Kanishk234/dwn-fpga-study/docs/technical-report.md

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

**Kanishk Sama · Krithik Sama**
The University of Texas at Austin

---

## Abstract

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

We built a hand-written Verilog implementation and a generator that compiles a trained checkpoint
into synthesizable hardware, verified every configuration bit-exactly against a software reference,
and deployed one to the board, where it classified all 166,000 test samples with zero mismatches.
We then swept 54 configurations through place-and-route to map the accuracy/area/latency frontier,
and compared the result against a gradient-boosted decision tree compiled to the same part through
the same synthesis flow.

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

---

## 1. Introduction

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

Differentiable Weightless Neural Networks [1] made this practical by showing how to train such
tables with gradient descent. The published results are strong, but they are demonstrated on a
Xilinx Virtex UltraScale+ VU9P, a data-centre part with roughly 1.18 million lookup tables. The
obvious question — whether the approach still works when the device is small — was open, and it is
not a question that theory answers, because on a small device the cost of preparing the *input* can
exceed the cost of the network itself.

This report answers it. Our contributions:

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

3. **A controlled comparison against a gradient-boosted decision tree** on identical silicon
   through an identical synthesis flow, rather than across papers and parts.

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

### 1.1 What we did not do

We did not measure a quantised multilayer perceptron compiled by hls4ml on our part. Its published
design needs three times our device's capacity, so it cannot fit unshrunk; shrinking it until it
fits is a separate experiment we did not run. Section 6.4 states the consequence, which is that our
comparison rests on one measured baseline rather than two.

---

## 2. Background

### 2.1 Lookup tables, in hardware and in the model

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

### 2.2 The architecture

A DWN processes data in four stages.

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

**Decision.** The class with the highest count wins, resolved by an argmax circuit.

No stage multiplies. The entire network is memory reads, one adder tree, and one comparison tree.

### 2.3 The encoder is not free

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

---

## 3. Implementation

### 3.1 Structure

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

### 3.2 Verification

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

Two experiences justify the strictness.

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

### 3.3 On real hardware

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

---

## 4. Design-space exploration

### 4.1 Method

Fifty-four configurations were trained and put through synthesis and place-and-route on the target
part at a 10 ns clock, out of context (that is, without surrounding system logic, so measurements
reflect the design alone). Fifty-two produced measurements; two were unbuildable for a reason
given in Section 8. Forty-one both fit the device and met the 100 MHz board clock.

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

### 4.2 Results

**Figure 1.** Accuracy against area for every configuration measured on our device, alongside
published results on the same dataset. Marker fill distinguishes designs whose area includes the
input encoder from those reporting the network alone; the two are not interchangeable (Section 5.2).

Accuracy against area, OpenML dataset

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

Four findings follow.

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

---

## 5. Comparing against published work is harder than it looks

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

### 5.1 "Jet substructure classification" is two datasets

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

The authors of NeuraLUT-Assemble state the situation plainly [4]:

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

**Consequence.** The comparison most often quoted — DWN against LogicNets, PolyLUT and NeuraLUT —
is across datasets. Those are CERNBox results. On the OpenML data the honest peer group is smaller
and stronger: DWN, TreeLUT, NeuraLUT-Assemble, FPGN, and hls4ml.

### 5.2 Area figures mix two conventions

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

### 5.3 Both defects begin upstream

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

---

## 6. Comparison results

### 6.1 Against a boosted decision tree, on identical silicon

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

**At a fixed area budget, which model is more accurate:**

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

**At a fixed accuracy target, which model is smaller:**

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

### 6.2 A conversion bug that would have invalidated every tree result

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

### 6.3 Against published work, on our dataset

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

| Method | Accuracy | Lookup tables | Encoder included | Part |
|---|---|---|---|---|
| **This work** (largest fitting) | **76.35%** | 18,777 | yes | XC7A35T |
| DWN, as published | 76.3% | 4,972 | **no** | VU9P |
| DWN, encoder included [3] | 76.3% | 7,011 | yes | VU9P |
| **This work** (headline) | **76.18%** | **12,751** | yes | XC7A35T |
| hls4ml [9] | 76.0% | 63,251 | n/a | VU9P |
| TreeLUT [7] | 76.0% | 2,234 | n/a | VU9P |
| NeuraLUT-Assemble [4] | 76.0% | **1,780** | n/a | VU9P |
| FPGN [5] | 76.0% | 3,345 | unstated | VU9P |
| Boosted tree (this work) | 74.88% | 15,363 | n/a | XC7A35T |

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

### 6.4 What is missing

We did not synthesize an hls4ml design on our part. Its published configuration needs 63,251
lookup tables against our 20,800 — three times over, which is arithmetic rather than an experiment.
What we therefore cannot report is **how much accuracy hls4ml retains when shrunk until it fits**,
which is a genuine open question.

This has a specific consequence. The "no DSP blocks" property is the sharpest distinction against
hls4ml, whose quantised networks spend 38 of them. But the boosted tree also uses none — trees do
not multiply either. **So on our own silicon that distinction is untested**; it rests on published
figures alone. A measurement of one shrunk hls4ml configuration would close this, and is in
progress at the time of writing.

---

## 7. The input word was six bits too wide

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

**The cause is comparator width, and nothing else.** That work normalises features to [−1, 1) and
quantises them to 6–9 bits. We carried a 16-bit word whose three integer bits exist only because
our features are standardised to roughly ±4.5, and whose twelve fractional bits are far finer than
the spacing between adjacent thresholds. Rebuilt at 8 bits, our encoder measures **182** lookup
tables against their 201. No structural technique was missing; the numbers were simply wider than
they needed to be.

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

Two further observations:

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

---

## 8. Limitations and threats to validity

**One measured baseline, not two.** With hls4ml unmeasured (Section 6.4), the controlled comparison
rests on boosted trees alone.

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

---

## 9. Conclusion

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

---

## References

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

[6] *A Survey on LUT-based Deep Neural Networks Implemented in FPGAs.* 2025. arXiv:2506.07367.

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

---

## Appendix A — How configurations are named

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

---

## Appendix B — Complete measurements

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

### B.1 Weightless network, representative configurations

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

### B.2 Boosted decision trees, all fitting configurations

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

### B.3 Encoder area against input word width

Measured on `1x2400 z=50`, 746 wired comparators, encoder synthesized alone.

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

### B.4 Published results, OpenML dataset only

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

---

## Appendix C — Reproducing this work

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

---

## Glossary

**argmax** — the circuit that selects the highest-scoring class. Ties resolve to the lowest index.

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

**critical path** — the slowest chain of logic between two registers. It sets the maximum clock
frequency.

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

**FPGA** — a chip whose logic is configured after manufacture, built largely from lookup tables.

**Fmax** — the highest clock frequency at which a design meets timing.

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

**popcount** — counting the ones in a group of bits. How class scores are computed here.

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
