Kanishk234/dwn-fpga-study/docs/phase1-ledger.md

# Phase 1 — CORE: running ledger

# ✅ PHASE 1 COMPLETE — Gate 1b passed 2026-08-04, 166,000/166,000 on hardware

**Live document. Update it as work lands, not afterwards.** Status table first, then the
chronological log, then the numbers worth quoting, then what is still open.

Phase 1's exit condition is Gate 1b (brief §11): *the bitstream running on the Basys 3
reproduces the software model's JSC test-set accuracy, to the sample.* Not "it lights the right
LED for a few inputs" — the full test set through benchmark mode, matching what PyTorch
reported. **That is now done.**

---

## Status

| Step | What | Status |
|---|---|---|
| **1a** | LUT6 mapping probe — does `TABLE[addr]` map to one LUT6? | ✅ risk #1 retired, `docs/probe-results.md` |
| **1b** | Reproduce DWN training; JSC checkpoint we trust | ✅ 74.06% vs paper's 74.0% |
| **1c** | Verilog templates, by hand, for one small real model | ✅ core + encoder |
| **1d** | Golden software model + bit-exact testbench — **GATE 1** | ✅ **both levels pass** |
| **1e** | Exporter (checkpoint → tables/wiring/thresholds) | 🟡 works, one-shot, not generalized |
| **1f** | RTL generator (export → Verilog) | ❌ `rtlgen/` empty |
| **1g** | Harness — UART, BRAM vector store, cycle counter, FSM, 7-seg | ✅ **all modules built and tested, incl. board top level** |
| **1h** | Board: bitstream reproduces test-set accuracy — **GATE 1b** | ✅ **166,000/166,000** |

### Not in the brief's list, but Phase 1 cannot finish without them

| Item | Why it matters | Status |
|---|---|---|
| `constraints/basys3.xdc` | required for a *bitstream*; OOC synthesis does not need it | ✅ |
| Bitstream | the real design, pins and all | ✅ **builds, meets timing** |
| `scripts/build.tcl` | non-project-mode build; the DSE sweep reuses it | ✅ |
| First synthesis run | the encoder-vs-core LUT split (brief §6) — unmeasured | ✅ **see below** |
| Pipeline registers (II=1) | brief §9; also a Phase 2 sweep axis | ✅ 4 stages, 161 MHz, II=1 |
| Full 166k test set | Gate 1b needs the whole set | ✅ produced and verified — see below |
| Host driver (`scripts/host.py`) | drives the `L`/`R`/`S` protocol, batches Gate 1b | ✅ encoding self-tested |

---

## Log

### 2026-08-02

- **1a probe** — `TABLE[addr]` maps to a single LUT6 as hoped. Risk #1 retired
  (`docs/probe-results.md`). This was the branch point for the whole area model.
- **Submodule pinned** at `9f887a0`. Upstream ships **PyTorch training only** — no RTL, no HLS,
  no FPGA flow. Confirms the gap the project exists to fill.
- **Kaggle training brought up.** `torch_dwn` has no CPU path (`EFDFunction CPU not
  Implemented`), so training runs off-machine. First build failed: upstream's `pyproject.toml`
  declares `torch` as a *build* requirement, so plain `pip install .` builds in an isolated env
  against a second, mismatched torch. Fix: `--no-build-isolation`.
- **Three training runs, three rejected hypotheses** — see `training/README.md` run log.
  z=4→8 bought +0.22pp; batch 256→32 bought +0.07pp; reading upstream showed lr/scheduler/
  epochs/tau/mapping already matched the authors' recipe exactly.
- **Checkpoint format recorded** from the pinned submodule, not inferred —
  `docs/checkpoint-format.md`. Closes risk #5.
- **Read the paper.** Table 14 gave the real JSC configs (`docs/paper-configs.md`): **z=200**
  and **single-layer**. We had been at z≤8 with a random-wired second layer.
- **Reproduced the paper's `sm` (1×50)**: 74.06% best / 73.84% final vs the paper's 74.0%.
  This is the Gate 1 reference checkpoint.
- **Python 3.12** chosen and pinned (`requirements.txt` header has the reasoning — Kaggle
  parity, and Phase 3's hls4ml/conifer lag new releases).
- **Extractor** (`exporter/extract.py`) — pulls tables/wiring/thresholds and verifies itself
  with a numpy forward pass against PyTorch's own predictions: **1000/1000**.

### 2026-08-03

- **Core RTL.** Hand-written `rtl/lut_node.v`, `popcount.v`, `argmax.v`; model-specific
  `rtl/gen/dwn_core.v` emitted by `exporter/emit_core.py`, which parses its own output back and
  checks tables, wire indices, and address bit order against the checkpoint.
- **GATE 1 PASSED (core)** — 1504/1504 via xsim. Vivado is at
  `C:\AMDDesignTools\2025.2\Vivado\bin`, not `C:\Xilinx`.
- **Precision measured, not guessed** (`exporter/analyze_precision.py`). Chose **Q3.12,
  16-bit**; **Q3.15/19-bit is the zero-bit-error fallback** if it is ever needed.
- **Gate 1 runner converted** from PowerShell to Python so `dse/` can import `run_xsim()` in
  Phase 2 instead of shelling out.
- **Thermometer encoder.** `exporter/emit_encoder.py` emits 202 comparators + `dwn_top`, with
  its own read-back check (202/202).
- **GATE 1 PASSED (top)** — 1518/1518 end to end, quantized features → encoder → core.
- **First synthesis run** (`scripts/build.tcl`, `scripts/run_synth.py`), out-of-context on
  `xc7a35tcpg236-1`. Two significant results — see *Area* and *Timing* below.
- **Pipelined.** Four stages via a parameterized `pipe_reg`, latency 4 cycles, II=1.
  81.2 → **161.0 MHz**, LUT count unchanged. Gate 1 re-run and still passing at both levels,
  now streaming a vector every clock — which is what actually proves II=1.
- **Harness started: UART.** `harness/uart_rx.v` + `harness/uart_tx.v`, 8N1, loopback-tested
  (`scripts/run_tb.py uart`): all 256 byte values back-to-back, zero mismatches, and a
  deliberately corrupted stop bit correctly reported as a framing error.
  - `BAUD` is a **parameter, defaulting to 115200**. Two reasons: first bring-up should fail
    for interesting reasons rather than marginal signal integrity, and **sweeping baud is how
    the I/O wall gets characterized** (brief §14) — so it must not be a constant. Brief §6's
    ~320 µs/sample figure assumes 1 Mbaud; raise it after Gate 1b.
  - `uart_rx` synchronizes `rx` through two flops (it is asynchronous to `clk`) and samples at
    each bit's midpoint, tolerating a half-bit of drift.
  - `uart_tx` has **no FIFO** by design: interactive mode sends one byte per classification and
    benchmark mode streams only after a run completes. `start` while `busy` is ignored, not
    queued — if a caller ever needs continuous streaming, add a FIFO around it rather than
    letting the transmitter drop bytes silently.
- **Harness: BRAM vector store + benchmark FSM.** `harness/vector_store.v`,
  `harness/benchmark_fsm.v`, tested by `scripts/run_tb.py benchmark`. Measured II=1 exactly:
  32 vectors in 37 cycles, 16 in 21, 1 in 6 — always `n + LATENCY + 1`.
  - **Found and fixed a real alignment bug.** The first version fed the "valid" flag into the
    label delay line at *issue* time but the label itself two cycles later, so every prediction
    was scored against the wrong sample's label. It produced a plausible accuracy number rather
    than an obvious failure — which is exactly why the unit test asserts an exact expected
    count with some labels deliberately wrong, instead of just checking that it runs.
  - The BRAM read and the classifier are pipelines with different entry points: a label can
    first be captured 2 cycles after its address is issued, while the prediction lands at
    `1 + LATENCY`. So the delay line is `LATENCY` deep and the valid flag has to enter it on
    the same cycle the label does.
- **Harness: UART loader + host protocol.** `harness/uart_loader.v`, tested end to end through
  a real `uart_tx`/`uart_rx` pair in both directions (`scripts/run_tb.py loader`).
  - **Second alignment bug, same family as the first.** `wr_en` is a registered pulse, so it
    asserts the cycle *after* it is set — but `wr_addr` was incremented in the same cycle,
    moving the address out from under the write. Every vector landed one slot late, and slot 0
    was never written. Caught only because the test reads the store back through
    `vector_store`'s own read port rather than trusting that the writes happened.
  - Tested through the real serial modules rather than by driving `rx_valid` directly: the
    likely board failure is in the *composition* (byte order, a reply racing `tx_busy`), which
    isolated protocol tests cannot see. Brief §12 risk #7.

### Host protocol

ASCII command bytes, so bring-up can be done from a plain serial terminal before any host
script exists. When the board goes quiet, typing `P` and seeing `0xA5` separates "the link is
dead" from "the design is wrong" in seconds.

| Command | Payload | Reply |
|---|---|---|
| `P` | — | `0xA5` |
| `L` | `n_lo n_hi`, then n × 33 bytes | — |
| `R` | `n_lo n_hi` | — |
| `S` | — | 9 bytes |

A record is **32 feature bytes then 1 label byte**. Feature bytes are **little-endian and in
order**: byte k → `x_flat[k*8 +: 8]`, so feature f occupies bytes 2f and 2f+1. This matches how
`tb/gen_vectors.py` packs `x_quant.hex`; getting it backwards silently transposes every feature,
which is why the test reads the store back and compares full 256-bit words.

Status reply is little-endian `cycle_count[31:0]`, `correct_count[31:0]`, then a flags byte
(bit 0 = benchmark busy). **Accuracy returns as a count, never per-sample predictions** — the
test set does not fit on the device, so Gate 1b batches and only totals cross the link.

No CRC or retries: the link is a 10 cm trace, `uart_rx` already flags framing errors, and a
corrupt load shows up immediately as a wrong accuracy. Cheap to add if that proves optimistic.

---

## Board top level — Gate 1b passes in simulation

`harness/dwn_basys3_top.v` wires loader → vector store → `dwn_top` → benchmark FSM → UART,
plus `harness/seg7.v` for the display. `scripts/run_tb.py top` drives the whole thing through a
real UART pair with **real golden vectors and the real classifier — nothing stubbed**:

```
vectors : 64
correct : 64 / 64
cycles  : 69 (expected 69, II=1)
path    : host UART -> loader -> BRAM -> dwn_top -> counters -> UART
```

The labels loaded are the golden model's own predictions, so **64/64 means the hardware agrees
with the software model on every sample, end to end, through the serial protocol.** That is Gate
1b's claim minus the silicon.

**Still open, and why 1h stays ❌:** real FT2232HQ timing, bitstream-level behaviour, clock and
reset on actual silicon, and timing closure after place-and-route. Brief §12 risk #7 exists
because none of that is simulatable.

### One deliberate simplification of brief §9, stated rather than smuggled in

The brief describes benchmark mode and interactive mode as **two datapaths**. The top level
builds **one**, because the host reproduces interactive behaviour exactly with `L 1 <record>`
then `R 1` — a single sample over UART, prediction on the display, still honestly slow because
the link dominates. A second datapath would duplicate the classifier interface and add a second
thing to verify for no behavioural difference.

The switch therefore selects what the **display** shows — `sw[0]=0` last class, `sw[0]=1` cycle
count — which is what §9 actually asks the 7-segment for. LEDs: busy, done, sticky framing
error, and the low byte of `correct_count`.

`LATENCY` is taken from the generated `dwn_top_params.vh`, never hand-copied: `benchmark_fsm`
aligns labels using it, and a drifted value would silently score every sample against the wrong
answer — a bug that has already happened once in this project.

---

## The full test set does not fit on the device

166,000 vectors × 256 bits = **42.5 Mbit**. The Basys 3 has **1.8 Mbit**. This is not a tuning
problem — Gate 1b has to run in **batches**: load `DEPTH` vectors, classify, accumulate accuracy
on-chip, repeat. `vector_store` at DEPTH=1024 costs ~265 Kbit (~15% of block RAM).

Only running totals cross the UART, never one prediction per sample. That is what `correct_count`
inside `benchmark_fsm` is for.

## UART speed ceiling

The FT2232HQ tops out at **~12 Mbaud**. At 100 MHz, `CLKS_PER_BIT = 100/12 = 8.33` — a 4% bit
error, too much for reliable 8N1. Either derive the UART clock from an MMCM that divides evenly
(96 MHz → 8, or 120 MHz → 10) or use a fractional accumulator. Clean integer rates from 100 MHz:
10M, 6.25M, 5M, 4M, 3.125M, 2M, 1M.

**Raising baud does not fix the I/O wall.** At 12 Mbaud a 32-byte sample still takes 26.7 µs
against the core's 24.8 ns — ~1,000× I/O-bound instead of ~2,600×. Streaming one sample at a
time can never reach core throughput over a serial link, which is the whole reason benchmark
mode exists (brief §9) and why quantifying this is a contribution rather than a defect (§14).

Where baud *does* matter is Gate 1b turnaround, since the full test set is 5.3 MB:

| Baud | Full test-set upload |
|---|---|
| 115,200 | ~8 min |
| 1 M | ~53 s |
| 12 M | ~4.4 s |

Plan: get Gate 1b working at 115200, then raise it — and sweeping baud *is* the I/O-wall
measurement, not a detour from it.

---

## Area — the encoder costs 14× the core

Out-of-context, post-synthesis, `xc7a35tcpg236-1`:

| Module | LUTs | % of device | FF | BRAM | DSP | comb delay |
|---|---|---|---|---|---|---|
| `dwn_core` | **108** | 0.52% | 0 | 0 | 0 | 10.194 ns |
| `thermometer_encoder` | **1519** | 7.30% | 0 | 0 | 0 | 2.962 ns |
| `dwn_top` | **1619** | 7.78% | 0 | 0 | 0 | 12.314 ns |

**The core reproduces the paper almost exactly: 108 LUTs against their reported 110** (Table 2,
`sm` 1×50). Independent confirmation that the extraction, the emitted RTL, and the area model
are all right — a different structure would not land within 2 LUTs by accident.

Zero DSPs and zero BRAM, as the paper claims for every DWN result. The model really does live
entirely in logic.

**The encoder is 14.06× the core.** Brief §12 risk #3 anticipated the encoder being
uncounted, citing Mecik & Kumm's *up to 3.2×*. Measured here it is **more than four times worse
than that worst case**. The whole design is still only 7.78% of the part, so nothing is at risk
— but every "% of Basys 3" figure derived from the paper's core-only numbers is a serious
underestimate, not a mild one.

Two caveats before this gets quoted anywhere:

1. **Our encoder is deliberately naive** — one independent 16-bit comparator per selected
   threshold, ~7.5 LUTs each. Mecik & Kumm built theirs with FloPoCo and presumably shared
   logic across thresholds of the same feature. Thermometer bits for one feature are
   comparisons of the same value against *sorted* constants, so there is real structure to
   exploit. Some of the 14× is DWN's encoder; some is ours.
2. **Post-synthesis, not post-implementation.** Routing is not done, so these are estimates.

**This makes `z` the most interesting sweep axis in Phase 2.** `z` drives the number of
selected thresholds, which drives encoder area directly — and encoder area dominates. The paper
fixes z=200 for every JSC config and never reports what it costs. Accuracy vs area vs `z`, on a
part where it binds, is unmeasured by anyone.

## Timing — pipelined, and it clears the board clock

Unpipelined the design was **12.314 ns / 81.2 MHz**, under the Basys 3's 100 MHz. Four pipeline
stages fixed that.

⚠️ **Correction (kept visible).** Earlier reasoning assumed the 202 comparators would be the
critical path. The measurement said the opposite: **core 10.194 ns, encoder 2.962 ns** — the
depth is in the popcount and argmax trees. Stages were placed accordingly.

Constrained at 10.0 ns (100 MHz), out-of-context, `xc7a35tcpg236-1`:

| Module | LUTs | % dev | FF | WNS | Fmax |
|---|---|---|---|---|---|
| `dwn_core` | 108 | 0.52% | 73 | +3.790 ns | 161.0 MHz |
| `thermometer_encoder` | 1519 | 7.30% | 0 | +7.013 ns | 334.8 MHz |
| **`dwn_top`** | **1619** | **7.78%** | **269** | **+3.790 ns** | **161.0 MHz** |

- **Pipeline: 4 stages** — after the encoder, the LUT layer, the popcounts, and the argmax.
  **Latency 4 cycles, II=1.** At the board's 100 MHz that is **40 ns** and **100 M
  classifications/s** from the core; at the achievable 161 MHz, 24.8 ns.
- **81.2 → 161.0 MHz**, and LUT count did not move at all (1619 either way). The stages cost
  flip-flops, not logic — 269 FFs on a part with 41,600.
- Stage placement is a `pipe_reg` parameter (`PIPE_ENC/LUT/POP/OUT`), not hand-wiring, because
  pipeline depth is a Phase 2 sweep axis (brief §10). `ENABLE=0` compiles a stage out entirely.

**The FF count confirms the dead-bit prediction.** `dwn_top`'s encoder register is nominally
3200 bits wide; synthesis kept **196**, having trimmed every bit that feeds no node. `dwn_core`
is exactly 73 = 50 (layer) + 20 (scores) + 3 (output), as designed.

**There is headroom worth sweeping.** +3.790 ns of slack at 100 MHz means a 3-stage version
probably still closes, trading a cycle of latency for 20 fewer FFs. That is exactly the
pipeline-depth axis Phase 2 is meant to explore, so it is a data point to collect rather than a
decision to make now.

### Encoder area: where the 14× actually goes

`exporter/analyze_encoder.py` breaks the 1519 LUTs down per feature. Two things stand out.

**Vivado is already near-optimal per comparator.** 1519 / 202 = 7.5 LUTs for a 16-bit signed
compare-against-constant, which is about `W/2` — what a carry-chain comparison costs. There is no
sloppiness to reclaim inside a comparator.

**Three features carry the cost and need full precision.** `mass_mmdt` (46 comparators),
`zlogz` (37) and `c1_b2_mmdt` (31) account for 114 of 202, and all need ~12 fractional bits.
Meanwhile `multiplicity` — an integer particle count — needs only 5 fractional bits for its 39
comparators, and `c2_b1_mmdt` only 6.

**Per-feature narrowing, measured:** `exporter/experiment_narrow_encoder.py` emits an encoder
using each feature's minimum width and synthesizes it.

| Variant | LUTs | vs baseline |
|---|---|---|
| `thermometer_encoder` (shipped, uniform 16-bit) | 1519 | — |
| `thermometer_encoder_narrow` (per-feature) | **1259** | **−17.1%** |
| *linear cost model predicted* | *1330* | *−12.4%* |

Bit-exact against the Q3.12 spec (0 differences across 202 comparators × 1000 samples — dropping
low bits of a signed word is an arithmetic shift, which is the same floor the encoding already
uses), and timing is unaffected (+6.638 ns).

**Not adopted.** 260 LUTs on a design occupying 7.78% of the part does not justify a spec change
that `extract.encode()`, `tb/gen_vectors.py`, `scripts/host.py` and the golden model all have to
match, plus a Gate 1 re-run. The experiment stays in `build/experiments/`, outside the shipped
flow.

### ⚠️ Projection: the encoder, not the model, decides what fits

Comparator count is `|unique thresholds selected|`, which grows with node count and **saturates
at `features × z` = 3200**. Scaling the paper's JSC configs at 7.5 LUTs each:

| Config | Nodes | Slots (`nodes×6`) | Comparators | Encoder LUTs | Core LUTs | Total vs 20,800 |
|---|---|---|---|---|---|---|
| `sm` 1×50 | 50 | 300 | **202 (measured)** | **1,519** | 108 | **7.8%** ✅ |
| `md` 1×360 | 360 | 2,160 | ≤ 2,160 | ≲ 16,000 | ~720 | ~80% — tight |
| `lg` 1×2400 | 2400 | 14,400 | → ~3,200 (saturated) | **~24,000** | ~4,972 | **>100%** ❌ |

**DWN-`lg` almost certainly does not fit on a Basys 3 — and the core is not why.** Its 4,972
core LUTs are 24% of the device, exactly as brief §6 predicts. The encoder alone would exceed the
whole part.

This is the sharpest form of the §6 warning: every "% of Basys 3" figure derived from the paper's
core-only numbers understates the truth by roughly an order of magnitude at large sizes, because
encoder cost scales with the model while the paper never counts it.

Two consequences for Phase 2:
- **`z` stops being a free accuracy knob** — it sets the saturation ceiling on encoder area. The
  paper fixes z=200 everywhere and never reports its cost.
- **Narrowing stops being optional.** −17% is a rounding error at 1,519 LUTs and the difference
  between fitting and not at 16,000. Adopt it when a config needs it, not before.

Caveat: comparator counts for `md`/`lg` are bounds, not measurements — the actual number depends
on how much the learnable mapping reuses thresholds, and only training those configs will say.
At `sm` it selected 202 distinct bits from 300 slots (67%), so real numbers may land below these
bounds.

### Post-route: it closes

Placed and routed (`scripts/run_synth.py --impl`), out-of-context, constrained at 100 MHz:

| Module | LUTs | FF | WNS post-synth | WNS post-route | Fmax post-route |
|---|---|---|---|---|---|
| `dwn_core` | 108 | 73 | +3.790 ns | +3.708 ns | 158.9 MHz |
| `thermometer_encoder` | 1519 | 0 | +7.013 ns | +7.084 ns | 342.9 MHz |
| **`dwn_top`** | **1619** | **269** | +3.790 ns | **+3.200 ns** | **147.1 MHz** |

**Area is identical post-route, and timing moved only modestly** — still 3.2 ns of slack at the
board's 100 MHz. Routing did not surprise us, which for a design at 7.78% of the part is what
you would hope but cannot assume.

⚠️ **Correction: this table previously read 155.6 MHz / +3.572 ns.** Those numbers were measured
with **unconstrained I/O paths** — `build.tcl` created a clock but set no `set_input_delay` or
`set_output_delay`, so input-to-first-register and last-register-to-output paths were excluded
from timing analysis entirely. The correct figure is **147.1 MHz**. The bug was caught by the
pipeline sweep below, where it produced an impossible result rather than a merely optimistic
one; see *Methodology* there. `dwn_core` and the encoder are unaffected — their worst paths were
internal either way.

Caveat: still out-of-context, so no I/O buffers. The real bitstream adds pad delays and a clock
network, which will shave more margin.

### Pipeline depth: 3 stages is the minimum that closes 100 MHz

`scripts/experiment_pipeline.py` sweeps the `pipe_reg` ENABLE parameters — a config is a
synthesis generic, not a code edit, which is exactly why the stages were parameterized
(brief §10).

| Variant | Cycles | LUTs | FF | WNS | Fmax | Latency @100 MHz |
|---|---|---|---|---|---|---|
| 4-stage (shipped) | 4 | 1619 | 269 | +3.790 | 161.0 MHz | 40 ns |
| 3-stage: no OUT reg | 3 | 1619 | 266 | +1.864 | 122.9 MHz | 30 ns |
| 3-stage: no POP reg | 3 | 1619 | 249 | +1.355 | 115.7 MHz | 30 ns |
| 2-stage | 2 | 1619 | 246 | **−0.571** | 94.6 MHz | ❌ fails |
| 1-stage (encoder only) | 1 | 1619 | 196 | **−1.883** | 84.2 MHz | ❌ fails |

- **LUT count never changes.** Pipelining costs flip-flops, not logic — 196 to 269 across the
  whole range, on a part with 41,600.
- **3 stages is the floor at 100 MHz.** Dropping to 2 misses by 0.571 ns.
- The 1-stage figure (84.2 MHz) closely matches the 81.2 MHz measured before any pipelining
  existed — an independent check that the sweep is measuring what it claims.
- **Not adopted.** Changing depth changes `DWN_TOP_LATENCY`, which `benchmark_fsm` uses to align
  labels, so it requires a Gate 1 re-run. 10 ns of latency is worth having for a trigger
  application, but not worth spending on the day before board bring-up. It is a Phase 2 data
  point, collected early.

#### Methodology: a bug this sweep exposed

The first run of this sweep reported the **2-stage variant as 3× faster than the 4-stage one**.
Removing pipeline registers cannot improve timing, so the measurement was wrong, not the design.

Cause: with no `set_input_delay`/`set_output_delay`, paths from input ports to the first
register and from the last register to output ports are unconstrained and silently omitted from
the report. Removing the output register moves a long path into that unanalyzed set, so slack
*improves* as the design gets worse. Fixed by constraining I/O against the same clock; zero
delay is pessimistic for a real board but identical across variants, which is what makes them
comparable.

The lesson generalizes: a result that is impossible in the right direction is easier to catch
than one that is merely optimistic. The post-route correction above came out of the same fix.

---

### 2026-08-04

- **Host driver** (`scripts/host.py`). Implements the `P`/`L`/`R`/`S` protocol, quantizes to
  Q3.12, and batches Gate 1b over the test set. `--selftest` needs no board: it regenerates the
  reference vectors from the checkpoint and checks that **200 re-encoded records match
  `tb/gen_vectors.py` byte for byte**. That is the check that matters — if the host packed
  features differently from the RTL testbenches, every feature would arrive transposed and the
  board would look broken. Added `pyserial` to `requirements.txt`.
  - Gate 1b loads the **software model's predictions as labels**, not ground truth. Disagreement
    with `pred` is a hardware bug; disagreement with `y` is just the model being wrong, which is
    already measured. Conflating them would make a correct board look broken.
- **Notebook now dumps the full test set** (`*_testset_full.npz`: `x_raw`, `y`, `pred` for all
  166k). Needs a Kaggle re-run to produce. `x_binarized` is deliberately excluded — at
  166k × 3200 bits it is ~530 MB and nothing consumes it, since the board's own encoder turns
  features into bits. Gitignored: tens of MB and fully regenerable.

---

## On the board: bitstream built, timing met

`constraints/basys3.xdc` + `scripts/build_bitstream.py`. Pin assignments come from Digilent's
Basys-3 master XDC — but written fresh, not copied: the master file in circulation had been
edited for an unrelated lab project (ports named `signal`, `outedge`, `slow_clk`, `sseg`), so
only the pin letters were reused.

| | Out-of-context | **On the board** |
|---|---|---|
| LUTs | 1619 (7.78%) | **2058 (9.89%)** |
| FF | 269 | **865** |
| BRAM | 0 | **8** |
| DSP | 0 | **0** |
| WNS @ 100 MHz | +3.200 ns | **+1.753 ns** ✅ |

The growth is the harness (UART, loader, benchmark FSM, seg7) plus I/O buffers; the 8 BRAMs are
the vector store. Slack fell as expected once the clock network and pads were real.

⚠️ **Correction (kept visible): this table previously read 2054 LUTs (9.88%) and +1.662 ns.**
Those came from an intermediate bitstream build, not the one that was frozen. Every other record
of this design — `docs/phase1-report.md`, `docs/phase2-handoff.md`,
`releases/phase1/MANIFEST.md` and the `EXPECTED` table in `scripts/verify_phase1.py` — says
**2058 (9.89%)**, and the frozen manifest records **+1.753 ns**. The reproduction run of
2026-08-04 rebuilt the bitstream from committed defaults and measured exactly 2058 LUTs and
+1.753 ns, confirming the ledger row was the stale one. FF/BRAM/DSP were never in dispute.
Slack is placement-dependent and allowed to drift by tens of picoseconds; the LUT count is not.

**Report both, never one as the other.** The out-of-context figures are the ones comparable to
the paper (its Table 2 is out-of-context too); these are what is actually on the silicon.

Timing exceptions live in the XDC rather than in `build.tcl`: `RsRx`, `btnC` and `sw` are
asynchronous (each passes through a two-flop synchronizer in RTL, which is what actually makes
them safe), and `RsTx`/LEDs/7-seg are human-speed. Constraining them against a 100 MHz clock
would report failures that mean nothing and bury the ones that do.

## Full test set: produced and verified

`training/dump_testset_kaggle.ipynb`, inference only — no retraining, so every number measured
against the current checkpoint stands.

- 166,000 samples, 9.4 MB, **software accuracy 73.8361%** — an exact match for the recorded
  `final_acc`, which is the notebook's own first self-check.
- First 1000 predictions match the committed `testvectors.npz` **1000/1000**, so this is
  provably the same model Gate 1 was verified against.
- `x_raw` differs from the committed 1000-sample file by up to **4.77e-7** (≈1 float32 ULP):
  the training notebook used sklearn's `scaler.transform()`, the dump notebook the equivalent
  `(x-mean)/scale`. Harmless, and provably so — **0 of 16,000 values differ once quantized to
  Q3.12**, which is the only precision the hardware sees.

## GATE 1b — PASSED on hardware

```
samples              : 166000
hardware == software : 166000/166000
core cycles          : 166815
wall clock           : 480.0 s
accuracy, float32 model     : 73.8361%
accuracy, Q3.12 (on hardware): 73.8349%
```

Every sample of the JSC test set, through the real bitstream on a real Basys 3, over the real
UART. `166815 = 166000 + 162 batches × (LATENCY + 1)`, so **II=1 held on silicon**, not just in
simulation.

### The I/O wall, measured and swept

Every row is a full 166,000-sample Gate 1b run, all passing 166000/166000.

| Baud | Wall clock | Link rate | I/O wall | Link efficiency | Note |
|---|---|---|---|---|---|
| 115,200 | 480.0 s | 346/s | 287,770× | 99.1% | starting point |
| 1,000,000 | 62.4 s | 2,659/s | 37,429× | 87.8% | host overhead appears |
| 1,000,000 | 55.1 s | 3,010/s | 33,060× | 99.4% | after host optimizations |
| **5,000,000** | **11.2 s** | **14,823/s** | **6,713×** | **97.8%** | **default** |
| 10,000,000 | — | — | — | — | ❌ no response |

**43× faster end to end**, with the core untouched throughout — it was never the bottleneck.
Core throughput comes from the on-chip cycle counter, so both sides of every ratio are
measurements rather than datasheet claims.

**Why 5 M and not 10 M.** Both ends divide 10 Mbaud exactly (100 MHz / 10, and the FT2232H's
120 MHz / 12), and the FT2232H is rated to 12 Mbaud — yet the board does not respond at all,
while 4 M and 5 M work perfectly. The limit is therefore the **FTDI Windows VCP driver**, not
this design. Reaching higher would mean driving the chip through FTDI's D2XX API instead of a
COM port, which is a different host program, not a different bitstream.

**What the 1 Mbaud row pair shows.** At 115200 the protocol was already 99% link-efficient, so
baud was the only lever. At 1 M it fell to 88% — the host's per-sample Python packing became
visible once the wire got fast enough. Fixing that (vectorized packing, one status round trip
per batch instead of two) recovered it to 99.4%, and the same fixes are what let 5 M reach
97.8%. Past ~1 Mbaud the bottleneck genuinely moves between wire and host, and both have to be
addressed.

⚠️ **The FTDI latency timer is a per-machine driver setting, not a repo change.** Default is
16 ms, which adds several seconds per run in round-trip latency. Set it to 1 ms: Device Manager
→ the COM port → Port Settings → Advanced → Latency Timer. **This must be redone on every PC** —
a teammate on a fresh laptop will see a slow run with no other symptom.

Baud is a build-time override, so sweeping it needs no source edit:
`scripts/build_bitstream.py --baud 2000000`. 100 MHz divides exactly at 1 M (÷100), 2 M (÷50),
4 M (÷25), 5 M (÷20), 10 M (÷10).

Both numbers are measurements — the core figure comes from the hardware cycle counter, not from
a datasheet. Brief §6 estimated ~2,600× at 1 Mbaud against a 50 M/s core; at 115200 baud against
a 99.5 M/s core it is two orders of magnitude worse. **The link is essentially the entire cost
of running this model.** That is contribution #4 in brief §14, now quantified rather than
argued.

### Two things Gate 1b exposed that 1,000 samples could not

**1. The reference model was wrong, not the hardware.** The first full run reported 5
disagreements in 20,480. Cause: `pred` in the test set came from PyTorch on **float32**
features, while the hardware implements **Q3.12** — a deliberate part of the spec. Scoring
hardware against the float model measures the quantization decision, not the hardware.

Confirmed in software before changing anything: the numpy **float** model agreed with the
reference on 20,480/20,480, and the numpy **Q3.12** model disagreed on exactly 5 — the same
count the hardware reported. `scripts/host.py` now computes the Q3.12 reference itself and
reports the float-vs-fixed divergence separately, as the characterization number it is.

Across the full set the two models differ on **30 of 166,000 samples (0.018%)**, worth
**−0.0012 pp** of accuracy. Q3.12 stands; the Q3.15 fallback was not needed.

**2. One feature value in 2,656,000 overflows Q3.12.** The full set contains a scaled feature at
8.08, past Q3.12's +8 ceiling — the 1,000-sample subset topped out at 5.92, so it never
appeared. Fixed by **saturating** in `extract.quantize()`, which is lossless here and proven so:
thresholds span [−18618, +17782] against a word range of [−32768, +32767], so a clamped value
stays on the same side of every threshold. Verified by comparing encoder bits with and without
clamping across all 166,000 samples — **identical**.

⚠️ **Correction to an earlier note in this ledger: Q3.15 would NOT have fixed this.** It has the
same 3 integer bits and therefore the same ±8 range; it buys precision, not headroom. The
overflow fix is saturation, or Q4.12 if a threshold ever sat near the edge.

## What the board actually shows

**Seven-segment**, selected by `sw[1:0]` (four hex digits):

| `sw[1:0]` | Shows | Example |
|---|---|---|
| `00` | last predicted class | `0002` = top quark |
| `01` | cycle count, low 16 | `0405` = 1029, a full 1024-sample batch |
| `10` | correct count | `0400` = 1024, a perfect batch |
| `11` | cycle count, high 16 | nonzero only past 65535 cycles |

Class indices are **alphabetical from `LabelEncoder`** — `0=g, 1=q, 2=t, 3=w, 4=z` — *not* the
physics ordering in brief §7. Index 2 is top, not W.

**LEDs:**

| LED | Meaning |
|---|---|
| `led[0]` | benchmark run in progress |
| `led[1]` | at least one run has completed since reset |
| `led[2]` | **UART framing error** (sticky) — bytes are being corrupted |
| `led[3]`, `led[4]` | echo `sw[0]`, `sw[1]` so the display mode is visible |
| `led[15:8]` | low byte of `correct_count` |

`led[2]` is the one to watch: it latches, because a framing error is a single-cycle event that
would otherwise be invisible, and it is the difference between "the design is wrong" and "the
wire is dropping bytes".

⚠️ `led[15:8]` is only the **low byte**, so it wraps: a perfect 1024-sample batch reads `0x400`
and lights *nothing*. Use `sw=10` on the seven-segment for the real value. The LEDs are a coarse
"something is happening" indicator, not a readout.

## Numbers worth quoting

| | |
|---|---|
| Model | JSC `sm`, 1× 50 nodes, n=6, z=200, single learnable-mapped layer |
| Accuracy | **73.84% final** (74.06% best epoch) — paper's `sm` is 74.0% |
| Core | 50 LUT6 nodes + 5× popcount(10) + argmax |
| Encoder | **202 comparators** of 3200 thermometer bits (6.3%) |
| Input format | Q3.12 signed, 16-bit → **32 bytes/sample**, matching brief §6's UART assumption |
| Q3.12 vs float32 | 10 encoder bit differences, **0 class changes** |
| Gate 1 | core 1504/1504 · top 1518/1518 |
| Area (OOC, xc7a35t) | core **108** LUTs (paper: 110) · encoder **1519** · top **1619** = 7.78% |
| Encoder / core | **14.06×** — vs the 3.2× worst case brief §12 risk #3 anticipated |
| Flip-flops | 269 total (196 encoder + 50 layer + 20 scores + 3 out) of 41,600 |
| Fmax | **147.1 MHz** post-route (+3.200 ns slack at 100 MHz); 84.2 MHz with a single stage |
| Latency | **4 cycles**, II=1 → 40 ns at the board's 100 MHz. 3 stages also closes (30 ns) |
| Throughput | **99.5 M classifications/s** core-side, measured on-chip — but I/O-bound in practice |
| Gate 1b | **166,000/166,000** on hardware, 11.2 s at 5 Mbaud |

⚠️ **Quote 73.84%, not 74.06%.** The saved weights are the final epoch; there is no
best-checkpoint tracking. The `.npz` predictions come from those same weights, so Gate 1 is
unaffected — but the number that matches the shipped artifact is the final one.

### Learnable Mapping did feature selection for free

Comparators per input feature, of 202:

| Feature | Comparators | | Feature | Comparators |
|---|---|---|---|---|
| `mass_mmdt` | 46 | | `m2_b2_mmdt` | 6 |
| `multiplicity` | 39 | | `c1_b0_mmdt` / `c2_b2_mmdt` / `d2_b1_mmdt` / `d2_a1_b1_mmdt` | 3 each |
| `zlogz` | 37 | | `c2_b1_mmdt` / `m2_b1_mmdt` | 2 each |
| `c1_b2_mmdt` | 31 | | `d2_a1_b2_mmdt` / `n2_b2_mmdt` | 1 each |
| `c1_b1_mmdt` | 17 | | **`d2_b2_mmdt`** | **0 — never read** |
| `n2_b1_mmdt` | 8 | | | |

Four features carry 153 of 202 comparisons, and the ones it favours (jet mass, particle
multiplicity) are the physically obvious discriminators — evidence the model learned structure
rather than noise. `d2_b2_mmdt` affects no output at all, so the UART protocol could ship 15
features instead of 16 (~6% off an I/O-bound path). **Don't act on that yet** — a different
seed would likely drop a different feature; confirm it is stable across configs first.

---

## Open questions and risks

| | |
|---|---|
| ~~Is our encoder unnecessarily large?~~ | 🟡 **Measured.** Per-feature narrowing gives −17.1% (1519 → 1259) and is not adopted at this size; see *Encoder area* below. The remaining cost is ~202 near-optimal comparators — most of the 14× is real, not naive construction. |
| ⚠️ **The encoder may decide what fits, not the model** | Comparator count grows with node count and saturates at `features × z` = 3200. The paper's `lg` (2400 nodes) would select nearly all of them — **~24,000 LUTs of encoder on a 20,800-LUT device**, against a 4,972-LUT core. See the projection below; it reshapes what Phase 2 can even attempt. |
| ~~Post-synth, not post-implementation~~ | ✅ **Closed.** Placed and routed: area identical, 155.6 MHz, +3.572 ns slack at 100 MHz. Still out-of-context (no I/O buffers); a real bitstream will shave some margin. |
| **Only 1000 test samples are local** | The full 166k set is on Kaggle. Gate 1b requires all of it, and the Q3.12 "0 class changes" result is 1000-sample evidence, not proof. |
| **Nothing has touched silicon** | Gate 1 is simulation. Brief §12 risk #7: UART framing, BRAM addressing, reset sequencing and timing closure are all untested. |
| **No pipelining, and it is now required** | 81.2 MHz < the board's 100 MHz. Stages belong in the core (10.194 ns), not the encoder (2.962 ns). |
| **Exporter is one-shot** | `emit_core.py` / `emit_encoder.py` target one model. Phase 2 needs `rtlgen/` to generalize over the sweep grid. |
| **MNIST through the same pipeline** — *stretch, after Phase 3 (brief §13)* | Scoped 2026-08-04 out of curiosity, not planned work. The export→RTL half is already dataset-agnostic — `extract.py` reads shape from the checkpoint, `emit_core.py` loops over layers, so a two-layer MNIST model needs no code change there. **Three things would break, all in the harness:** (1) `uart_loader` has `reg [5:0] byte_idx` and `VEC_BYTES[5:0]`, fine for JSC's 33-byte records but MNIST's are 784×2+1 = **1569 bytes** and would need 11 bits — it would wrap silently, not fail loudly; (2) `LABEL_W=3` holds 0–7, MNIST needs 4 bits for 10 classes; (3) **BRAM** — MNIST vectors are 49× bigger, so `DEPTH=1024` would want 12.8 Mbit on a 1.8 Mbit device, forcing ~128-vector batches (or 8-bit pixels for ~256) and many more round trips. Plus MNIST loading in the training notebook and a rerun of the precision analysis (pixels are 0–255; Q3.12 is pointless, 8-bit integers suffice). **~1–2 days, mostly width fixes.** ⚠️ **MNIST's 97–98% is NOT a better result** — it is an easier dataset; everyone scores ~97% there and ~76% on JSC. JSC is the benchmark *because the whole LUT-DNN literature reports on it*, which is what makes a comparison table possible. Brief §13 calls MNIST "a sanity target, not a project". The genuinely interesting part would be that it stresses the **encoder and the I/O path** rather than the LUT core — a different bottleneck, not a bigger number. |
| **Try FTDI D2XX to get past 5 Mbaud** — *optional, revisit if Phase 3 leaves time* | 10 Mbaud divides exactly on both ends (100 MHz ÷10, FT2232H 120 MHz ÷12) and the chip is rated to 12 M, yet the board does not respond at all while 4 M and 5 M are perfect. The wall is the **Windows VCP driver**, not the design — so an MMCM would not help. Driving the chip through FTDI's **D2XX** API instead of a COM port might reach 12 M: 11.2 s → ~4.6 s. Cost: rewrite the host transport, add a dependency, lose `--list-ports` simplicity. **Payoff is ~2× on a run that already takes 11 s**, so it is a curiosity, not a need — but it would add two more points to the I/O-wall curve, which *is* a stated contribution (brief §14). |
| **`rtl/gen/` is committed — decide before the first sweep run** | Fine now: one model, and these are the exact files Gate 1 verified and synthesis measured, so history is useful. It does not survive 40–70 sweep configs. Undoing it later is cheap (`git rm --cached rtl/gen/` + a `.gitignore` line, no history rewrite), so the deadline is **before the sweep starts committing configs**, not the start of Phase 2 as such. |

---

## Frozen: `releases/phase1/`

The bitstream that passed Gate 1b, plus a manifest recording the commit, checkpoint hashes, tool
versions and measured results. Phase 2 will churn the emitters and the RTL; this directory does
not change.

Its real job is diagnostic. **If a Phase 2 change makes the board misbehave, reflashing this
tells you in a minute whether the board and toolchain are fine and the change is at fault** —
otherwise that is an afternoon of bisecting.

```
.venv\Scripts\python.exe scripts\program.py --bit releases\phase1\dwn_basys3_top.bit
```

Built from committed defaults with no flags, then programmed and re-verified at 166000/166000
before being copied here — so the manifest describes an artifact that was actually tested, not
one that merely came out of the same directory.

## Pointers

- `docs/phase1-report.md` — **the written-up account**: results, the five things that cost time,
  and full reproduction steps for another machine. This ledger is the raw log it was built from.
- `releases/phase1/MANIFEST.md` — the frozen bitstream and its provenance
- `docs/project-brief.md` — the full plan; §6 resource budgets, §11 phase breakdown, §12 risks
- `docs/checkpoint-format.md` — what the exporter reads, verified against the pinned submodule
- `docs/paper-configs.md` — the paper's JSC configs (Table 14 / Table 2) and what they changed
- `docs/probe-results.md` — Phase 1a, risk #1 evidence
- `training/README.md` — the run log and how to retrain
