Kanishk234/dwn-fpga-study/docs/jsc/phase2-ledger.md

# Phase 2 — DSE: running ledger

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

**Status (2026-08-10): PHASE 2 COMPLETE.** 54 configurations measured, all Gate 1 verified and
placed-and-routed. Headline: **`1x2400 z=50` — the paper's `lg` width — 76.18% at 61.3% of the
device, 101.3 MHz.** Report: `docs/jsc/phase2-report.md`. Superseded status note follows.

**Status (2026-08-08): tooling complete, waiting on training.** 2a, 2b and 2d are done and
validated against Phase 1's measured numbers; 2g's tooling is built. **2c is the critical path**
— 32 Kaggle training runs, restarted after the tau fix below. 2e/2f/2g are then one command
each. Phase 1 remains complete (`docs/jsc/phase1-report.md`), Gate 1b 166,000/166,000 on hardware.

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

Read first: `docs/jsc/dse-plan.md` (what gets swept and why), `docs/jsc/phase2-handoff.md` (machine
setup and the restructure decision), `docs/jsc/phase1-report.md` (what already works).

---

## Status

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

### Prerequisites before any of the above

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

---

## Step 2a in detail — what "config-driven" actually means

Roughly 20% file moves, 80% code. `docs/jsc/phase2-handoff.md` Part 2 has the directory decision;
this is the work behind it.

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

**The actual work** — four things are hardcoded today that a sweep must vary:

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

## What Phase 1 already answered

`docs/jsc/dse-plan.md` §7 listed four open questions. Three are now measured, and two of the answers
change the plan.

### 1. Encoder cost — far worse than budgeted ⚠️

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

| Config | Nodes | Comparators | Encoder LUTs | Core LUTs | vs 20,800 |
|---|---|---|---|---|---|
| `sm` 1×50 | 50 | **202 (measured)** | **1,519** | 108 | **7.8%** ✅ |
| `md` 1×360 | 360 | ≤ 2,160 | ≲ 16,000 | ~720 | ~~~80% — tight~~ **see below** |
| `lg` 1×2400 | 2400 | → ~3,200 | ~24,000 | ~4,972 | **>100%** ❌ |

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

### 2. Pipeline depth does move Fmax — Group B does not collapse

dse-plan §7 asked whether extra stages buy anything. Measured on `dwn_top`:

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

### 3. Reduction cost — the deferred decision now has a number 🟡

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

### 4. Real widths for the size ladder

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

---

## Constraints carried out of Phase 1

Things that will silently produce wrong sweep points if forgotten:

- **Final layer width must be divisible by `num_classes`.** `GroupSum` zero-pads silently
  otherwise, and hardware and software then disagree about group boundaries
  (`docs/reference/checkpoint-format.md` §4). The emitter asserts this; the sweep grid must respect it.
- **`tau` tracks layer width.** It is not a constant to copy from `sm` — see the paper's values
  above.
- **Vector store depth limits batch size**, and bigger models mean wider vectors. `DEPTH=1024` ×
  259 bits ≈ 265 Kbit today, ~15% of block RAM.
- **The Q3.12 reference, not the float model**, is what hardware is scored against. Quantization
  is spec, not error (Phase 1 lost a debugging cycle to this).
- **One machine, one Vivado version**, or the frontier is two half-frontiers.

---

## Log

### 2026-08-04 — Phase 1 reproduced on this machine (the Phase 2 entry gate)

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

```
Gate 1               : core 1504/1504 · top 1518/1518 · 50 nodes · 202 comparators
harness unit tests   : PASS
dwn_core             : 108 LUT   73 FF
thermometer_encoder  : 1519 LUT   0 FF
dwn_top              : 1619 LUT 269 FF
board design         : 2058 LUT 865 FF 8 BRAM 0 DSP · WNS +1.753 ns
Gate 1b              : 166000/166000 · 166815 core cycles
accuracy             : float32 73.8361% · Q3.12 73.8349%
float-vs-fixed       : 30/166000 (0.0181%) · 1 saturation event
```

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

**Two corrections came out of this run:**

- `docs/jsc/phase1-ledger.md`'s board table read **2054 LUTs / +1.662 ns**; the measured value is
  **2058 / +1.753 ns**, matching the report, handoff, manifest and `verify_phase1.py`. Ledger
  corrected in place with the retraction kept visible.
- The 166k test set is gitignored and **does not travel with the repo**. It was absent here and
  cannot be regenerated locally — upstream `torch_dwn` has no CPU path, so even inference needs
  a GPU. Copied from the Phase 1 machine and verified before use: 166,000 samples, software
  accuracy 73.8361%, first 1000 predictions 1000/1000 against the committed `testvectors.npz`,
  and `x_raw` max diff 4.768e-07 — the recorded 1-ULP `scaler.transform()` fingerprint, which
  is what proves it is the same dump rather than a re-derived one.

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

### 2026-08-07 — 2a step 1: the config object exists

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

Two details worth recording:

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

### 2026-08-07 — 2a step 2: both emitters take an output directory

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

**Verified three ways, not one:**

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

`rtlgen/config.py`'s self-test still passes, so the pipeline constants have not drifted.

### 2026-08-10 — RETRACTION: the reduction is 35% of the headline design, not 3.6%

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

Reduction cost, taken as `core LUTs - node count` (one node is exactly one LUT6, measured):

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

At the headline config the split is **encoder 45%, reduction 35%, actual neurons 19%.**

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

#### What Learnable Reduction would actually do -- it is NOT a drop-in replacement

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

What it does is **shrink what the popcount operates on**:

```
now:       2400 bits ─────────────────► GroupSum(5), groups of 480 bits
pyramid:   2400 → 500 → 100 bits ─────► GroupSum(5), groups of 20 bits
```

Projected with the measured cost model:

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

#### Cost to build it

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

#### Also verified while checking this

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

### 2026-08-10 — THE CORNER RESULT: the paper's `lg` fits, and the wall is timing

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

#### ⚠️ Correction to the Phase 1 projection, and it is a large one

`docs/jsc/phase1-ledger.md` projected the paper's `lg` (1×2400) as **">100% of the device — does not
fit"**, on an encoder estimate of ~24,000 LUTs against a 20,800-LUT part. That was computed at
z=200 and reported as a property of the *model*.

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

#### The binding constraint changed identity

Every config that now fails, fails on **timing with area to spare**:

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

#### The mechanism: the knees compound because they cost in different places

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

#### A bug the result exposed in `report.py`

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

### 2026-08-09 — Group B extended to four rungs, and it overturned the reported result

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

### 2026-08-09 — Vivado thread count raised, verified not to move the numbers

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

Tested rather than assumed. `1x600` re-synthesized at 8 threads:

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

### 2026-08-09 — `build/` is now safely disposable

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

`load_results()` now falls back to the committed snapshot (`docs/jsc/results/sweep-results.json`),
so wiping `build/` costs nothing but disk and the next run rebuilds only what is genuinely
missing. **The ordering matters: snapshot, commit, then delete** -- the fallback recovers what
was committed, not what was not.

### 2026-08-09 — Corner configs queued: the two knees were never combined

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

Ranked every pair before choosing, and only one survives:

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

### 2026-08-09 — THE WALL, MEASURED: `1x1600` fits, `1x2000` does not

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

```
HEADLINE: largest DWN measured to fit an XC7A35T
  1x1600 -- 1600 nodes, n=6, z=200
  76.35% accuracy
  18,777 LUTs (90.27% of device) = core 4,124 + encoder 14,316
  0 BRAM, 0 DSP
  103.2 MHz, latency 4 cycles, II=1

THE EDGE:
  1x2000 -- 21,382 LUTs (102.80% of device), WNS -0.538 ns (94.9 MHz)
            fails on BOTH axes: over the part AND misses the board clock
```

#### ⚠️ A config can complete Vivado's flow and still not fit

`1x2000` was recorded `status: ok`, because `run_one` only checks that the flow returned
success. It did:

```
post-synthesis : 20,126 LUTs  (96.76%)   <- fits, so placement proceeded
post-route     : 21,382 LUTs (102.80%)   <- physical optimization pushed it over
place_design completed successfully
```

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

#### The full ladder

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

#### The finding that matters more than the headline

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

#### The encoder/core ratio inverts across the ladder

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

### 2026-08-09 — THE SWEEP: 35 configs measured, and the area model was rebuilt on them

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

#### Headline

```
1x1200   76.30%   16,061 LUTs (77.22% of device) = core 2,868 + encoder 12,824
         100.7 MHz, 4 cycles, II=1
```

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

#### The area model was wrong by 2x, and it cost two configs

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

#### Results that answer the study's questions

**`z=200` is past the knee -- the paper's unexamined constant, now costed.** At 1x360:

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

#### ⚠️ Group B: no reduced-pipeline variant meets the board clock at 1x360

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

#### Failures, kept as results

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

#### Calibration: the noise floor

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

### 2026-08-09 — ⚠️ The encoder narrowing result was fitted and tested on the same data

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

Re-derived against the full 166k set:

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

**Consequences:**

- The "-17.1%, not adopted" line in `docs/jsc/phase1-ledger.md` should be read as **-13%, and the
  original was never safe to adopt**. Not adopting it was right for a better reason than the one
  recorded.
- **Narrowing is data-dependent per config.** Widths must be derived from the full test set, not
  a subset, and re-derived for every sweep point -- its thresholds differ. Any future adoption
  has to fit on 166k and re-verify through Gate 1.
- The general lesson is the same one the emitter read-back check taught: **a check that uses the
  same input as the thing it checks proves only self-consistency.**

### 2026-08-09 — The frontier edge can be MEASURED, not predicted

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

#### The area model extrapolates well -- 7x past its calibration range

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

### 2026-08-09 — Filtered configs keep their accuracy

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

### 2026-08-08 — The deliverable figures were broken at full grid size

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

#### A silent mis-classification found while fixing #4

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

### 2026-08-08 — Gate 1 at n=4 and n=2, without training either

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

```
n=4   core 1504/1504   top 1519/1519   PASS
n=2   core 1504/1504   top 1516/1516   PASS
```

**First time n!=6 RTL has ever been simulated.** Four grid configs depend on it.

#### The test was then verified to be capable of failing

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

| packing | mismatches | verdict |
|---|---|---|
| old (`np.packbits`) | **958 / 1504** | FAIL |
| fixed | 0 / 1504 | PASS |

#### ⚠️ And that run exposed a limit of the emitter's self-check

With the bug present, `emit_core.py`'s read-back check still reported **20/20 nodes match**.

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

### 2026-08-08 — Multi-layer verified, not assumed

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

```
400 lut_node instances, 128-bit input, 2 layer(s)
core latency 4 cycles (= PIPE_LUT x 2 + POP + OUT), top latency 5
read-back: 400/400 nodes, 124/124 comparators
GATE 1: core 1504/1504, top 1519/1519, PASS
```

Three things this covers that nothing else did:

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

### 2026-08-08 — ⚠️ LUT tables were emitted shifted at n=2

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

**This was more dangerous than an ordinary off-by-one.** `docs/jsc/dse-plan.md` §3 *predicts* n=2
fails — routing congestion — and states that such a failure "is a data point marking the
frontier's edge, not a mistake to prevent." A Gate 1 failure caused by this bug would have
looked exactly like the expected architectural finding, and could plausibly have been written up
as one. Gate 1 would have caught the mismatch; nothing would have caught the misattribution.

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

### 2026-08-08 — ⚠️ `tau` interpolation was wrong; training restarted

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

### 2026-08-08 — Group B paths validated before the sweep needs them

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

### 2026-08-08 — 2d: the area filter, with a probe band that keeps the wall measurable

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

Current effect on the ladder:

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

### 2026-08-07 — Sweep results are committed evidence; the weights are not

`dse/report.py --snapshot` writes `docs/jsc/results/sweep-results.{json,csv}`.

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

### 2026-08-07 — First sweep points, and the area model recalibrated on them

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

#### Correction 1: the core term was underestimating by up to 19%

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

**Core error: +14% / +19% → under 0.5% on all three configs.**

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

#### Correction 2: encoder saturation is `used_features × z`, not `features × z`

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

#### The self-test now separates the two kinds of wrong

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

### 2026-08-07 — `--impl` validated through the runner

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

```
core 108 | encoder 1519 | top 1619 | Fmax 147.1 MHz | 379s
```

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

### 2026-08-07 — The reduction, measured: 50 + 58 = 108 exactly

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

**Two results, and the first is the more valuable.**

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

### 2026-08-07 — 2c: the grid training notebook

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

### 2026-08-07 — 6d: results, frontier, plots — and three bugs it caught first

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

Two constraints worth recording because they are not aesthetic:

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

### 2026-08-07 — 2a step 6c: the sweep runner, and 2a is done

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

**The baseline config went through the whole pipeline and reproduced Phase 1 exactly:**

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

### 2026-08-07 — 2b: the area model, recalibrated and honest about what it cannot predict

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

**Projected size ladder**, and it revises an earlier ledger entry:

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

### 2026-08-07 — 2a step 6b: the sweep grid

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

### 2026-08-07 — 2a step 5: the restructure

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

```tcl
foreach f $sources { ... lappend inc_dirs [file dirname $f] }
```

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

### 2026-08-07 — 2a step 3: pipeline depth is an argument, not a constant

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

**Verified:**

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

### 2026-08-04 — Encoder sharing: measured, and it is a dead end ❌

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

**Two ideas, both dead, and the reasoning is recorded so nobody re-derives them.**

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

---

## Numbers worth quoting

*(empty — Phase 1's are in `docs/jsc/phase1-ledger.md`)*

---

## Open questions

| | |
|---|---|
| **Is Learnable Reduction worth building?** ⚠️ **REOPENED 2026-08-10** | Closed on 2026-08-07 as "3.6% of the design, not worth it" — measured at `sm` and generalised. **At `1x2400 z=50` the reduction is 4,450 LUTs, 34.9% of the design**, second only to the encoder. A LUT pyramid shrinking 2400 bits to ~100 before the popcount projects to ~710 LUTs, saving ~29% of the design, plus two pipeline stages the timing-limited configs needed. RTL is nearly free (`emit_core` already loops over layers); the training code is new. See the 2026-08-10 entry. |
| **Does `md` actually fit?** | The bound says ~80% of the part, which is tight enough that routing (not LUT count) may decide it. A failure to route is a data point, not a mistake (brief §12 risk #2). |
| **How many thresholds does a bigger model really select?** | `sm` chose 202 of 300 slots (67% unique). If that ratio holds, `md`/`lg` encoder estimates drop. Only training says. |
| **Per-feature comparator narrowing** | Measured −17.1% at `sm` and not adopted — 260 LUTs did not justify a spec change. **At `md`/`lg` it may decide whether a config fits at all.** Revisit when a config is marginal. Now the *largest* remaining RTL-side lever, since sharing is dead (below). |
| ~~Can comparators share logic across thresholds of a feature?~~ | ❌ **Closed 2026-08-04, negative.** Binary-search decode is arithmetically worse (mux cost doubles per level); shared high-bit prefixes bound at **−5%** because quantile-spaced thresholds do not cluster. See the log entry. `exporter/analyze_encoder_sharing.py` re-runs it for any checkpoint — worth repeating if a config ever uses evenly-spaced `Thermometer`, where clustering should be much stronger. |
| **`z` is the axis nobody has swept** | The paper fixes z=200 for every JSC config and never reports its cost. `z` sets the saturation ceiling on encoder area, which dominates. Accuracy vs area vs `z`, on a part where it binds, is unmeasured by anyone — probably the single most publishable axis here. |
| **Slim checkpoint format — would make every trained config committable** | Sweep checkpoints total ~933 MB and one is ~122 MB, over GitHub's per-file limit, so they are gitignored. But **91% of a checkpoint is `mapping.weights`**, an `input_bits × (nodes×n)` tensor used *only during training*: `extract_wiring()` reads it once, takes `argmax(axis=0)`, and keeps `nodes × n` integers. Storing the resolved wiring instead would cut a 101 MB checkpoint to **~350 KB** and the whole grid to **~4 MB** — committable, with faster loads as a bonus. **Not attempted mid-sweep**, deliberately: it changes the checkpoint format on the Gate 1 path, and `extract.py`'s own comment warns that `__dummy_mapping` has the same shape and dtype as a real mapping, so getting this wrong yields "a valid-looking, totally wrong export" — silently. Build it after the sweep, with a Gate 1 re-run proving slim and fat checkpoints emit byte-identical RTL. **Zipping is not the alternative: measured 1.09×**, since float32 weights are near-incompressible. |
| **3-stage pipeline** | Closes 100 MHz post-synthesis but was never re-verified post-route. One cheap Group B point. |
| **FTDI D2XX for >5 Mbaud** | Optional; the VCP driver, not the design, is the wall. Two more I/O-wall points if Phase 3 leaves time. |
| **Package the generator as a reusable tool** — *scoped, after Phase 3* | `docs/reference/reusable-generator.md`. No open RTL implementation of DWN targets small FPGAs, which is why this project exists — and the generator is most of one already: verified across 20–2400 nodes, 1–3 layers, n=2/4/6, z=8–800, three encodings, and both wiring representations. What is JSC-specific is the *plumbing*: hardcoded Q3.12, and a harness shaped around 33-byte records and 5 classes. **~1–2 weeks, almost none of it RTL.** The load-bearing item is the MNIST port, because it is the only one that *tests* generality rather than asserting it. Split by forking after Phase 3 — the history is where the reasoning lives. |
| **MNIST port** | Stretch, after Phase 3. Scoped in `docs/jsc/phase1-ledger.md` — three harness breakages, ~1–2 days, and a *higher* accuracy number that means less, not more. |

---

## Pointers

- `docs/jsc/dse-plan.md` — what gets swept, the knob groups, the strategy
- `docs/jsc/phase2-handoff.md` — machine acceptance test + the `rtlgen/` restructure
- `docs/jsc/phase1-report.md` — what already works, and how to reproduce it
- `docs/jsc/phase1-ledger.md` — Phase 1's raw log and its open questions
- `docs/reference/project-brief.md` §10 — the DSE study as originally specified
