Kanishk234/dwn-fpga-study/docs/mnist/phase1-ledger.md

# MNIST Phase 1 ledger — bring-up on a second dataset

Running log for the MNIST port. Plan and ground rules: `docs/mnist/plan.md`.

**Branch:** `mnist`. `main` holds the JSC study, tagged `jsc-complete`.

**What this phase is for:** getting a real MNIST model onto this device, bit-exact, and
generalising the flow in the process. **Both outcomes count** — MNIST accuracy is a second
dataset's worth of results, comparable against published MNIST rows (PolyLUT 96% / 70,673 LUTs,
NeuraLUT 96% / 54,798) and, for the first time in this project, against the weightless lineage
itself: ULEEN and BTHOWeN benchmark on MNIST and report no JSC at all.

Phase 1 is bring-up only. Accuracy work belongs to the sweep that follows it, exactly as JSC's
did.

**Correct entries rather than appending to them.** When a measurement overturns an earlier
conclusion, strike the old one through and say what was retracted and why. A wrong turn that stays
visible is worth more than a tidy log — four conclusions in the JSC study were generalised from a
single configuration and had to be withdrawn, and every one was caught by measuring at a second
point.

---

## Status

| Step | What | Status |
|---|---|---|
| M1a | Derive the feature count; add `datasets/` descriptors | ✅ done 2026-08-11 — JSC identical |
| M1b | Thread configurable precision through the flow | ✅ done 2026-08-11 — JSC identical, Gate 1 passes at 11-bit |
| M1c | Train a small MNIST model (Kaggle, off-machine) | ✅ done 2026-08-11 — ~~96.14% (best 96.28%)~~ → **96.77%** (best 96.88%) after the `tau` correction, see open questions |
| M1d | Export and pass Gate 1 bit-exact | ✅ done 2026-08-11 — **PASS on the trained model**, and Q0.8 is lossless |
| M1e | Synthesize; measure core / encoder / top separately | ✅ done 2026-08-11 — **1,548 LUTs (7.4%), 108.0 MHz** after the argmax fix |
| M1f | Harness record format and vector-store capacity | ✅ done 2026-08-11 — **verified on silicon 2026-08-12** |
| M1g | Gate 1b on the board, full MNIST test set | ✅ **done 2026-08-12 — 10,000/10,000** |

**Scope, 2026-08-11 — two questions, and only one is answered.**

**The tool ships generator-only:** synthesizable Verilog for the network, no harness, because the
harness changes with every application and dataset. That is a decision about a deliverable *after*
a successful port.

~~**Whether MNIST runs on our board here is still open.**~~ ✅ **Answered 2026-08-12: yes.**
Gate 1b passes 10,000/10,000 on silicon at 4,586 LUTs (22.05%), meeting 100 MHz. The projection
above was close on the record size (1,569 bytes) and wrong on the time — 31.9 s, not ~23 minutes,
because that assumed 115,200 baud and the link runs at 5 Mbaud.

**The gate, after every generalisation commit** — `scripts/verify_phase1.py` at **12/12 with areas
110 / 1,519 / 1,621** (⚠️ *not* the 108 / 1,519 / 1,619 this file was written with; the argmax tree
costs +2, and the pre-change values live at the `jsc-complete` tag), plus `run_gate1.py` on the
two-layer `300-100` checkpoint. Identical, not close. See `docs/mnist/plan.md` §1.2.

---

## Numbers to beat, or to fail against honestly

The JSC baseline this generalisation must not disturb:

| | |
|---|---|
| Gate 1 | bit-exact, 1,504 core vectors / 1,518 top vectors |
| `dwn_core` | ~~108~~ → **110 LUTs**, 73 FF |
| `thermometer_encoder` | **1,519 LUTs**, 0 FF |
| `dwn_top` | ~~1,619~~ → **1,621 LUTs**, 269 FF |
| whole board design | ~~2,058~~ → **1,893 LUTs**, 864 FF (post-route) |
| On silicon | 166,000 / 166,000 exact — **re-confirmed 2026-08-12** |

The struck values are the `jsc-complete` tag's, which is what `docs/jsc/report.md` and `README.md` quote.
The current ones include the argmax tree (+2 in the core, +2 in `dwn_top`) and the loader shift
register (−167 on the board). Do not mix the two columns in one table without saying which is
which.

What MNIST is walking into, for scale:

| | JSC | MNIST |
|---|---|---|
| input features | 16 | **784** |
| classes | 5 | **10** |
| paper's smallest model | 1 layer, 50 nodes | **2 layers, 1000 + 500** |
| board record | 33 bytes | **~1,569 bytes** at 16-bit |

⚠️ ~~The paper's MNIST configuration is not expected to fit — its encoder alone extrapolates to
roughly 67,000 LUTs.~~ **Retracted 2026-08-11, see the log.** That assumed every input slot reads a
distinct threshold; the learned mapping reuses them heavily. Corrected: the paper's configuration
is **over at 16-bit (102.5%) and fits comfortably at 11-bit (38.0%)**. Word width, not `z`, is what
decides whether MNIST runs here.

---

## Log

### 2026-08-12 — M1g: MNIST passes Gate 1b on the board, 10,000/10,000

**The port is real hardware now, not simulation.**

| | MNIST | JSC (same day, same tree) |
|---|---|---|
| **Gate 1b** | **10,000 / 10,000** | **166,000 / 166,000** |
| fixed-point vs float32 | **0 / 10,000 differ** | 30 / 166,000 (0.018%) |
| accuracy, both models | **96.1400%** | 73.8361 / 73.8349% |
| board area | 4,586 LUTs (22.05%) | 1,893 (9.10%) |
| core throughput | 76.2 M samples/s | 76.1 M samples/s |
| over the link | 313 samples/s | ~14,800 samples/s |
| **I/O wall** | **243,271×** | ~5,100× |

**Q0.8 is lossless on the full test set, not just the 1,000-sample subset** — 56,835 feature
values saturate and not one flips an encoder bit, exactly as the descriptor's reasoning predicted
(8-bit pixels have only 256 distinct values, so nine bits cannot lose anything). This is the
sharpest contrast with JSC, where fixed point costs 30 samples because the features are genuinely
continuous.

#### The I/O wall is 48× worse than JSC's, and that is the whole streaming argument in one number

The core classifies one vector per clock regardless of dataset; the link carries 1,569 bytes per
MNIST record against JSC's 33. So the ratio is what changes, not the core. **It also settles that
streaming cannot measure throughput** — at 243,271× the link dominates by five orders of
magnitude, so any UART-bound harness measures the UART. `cycle_count` stays a batch-mode number.

#### The full test set did not need Kaggle

`scripts/dump_testset.py` is new. The float32 and fixed-point golden models differ ONLY in the
thermometer comparison — LUT lookup, GroupSum and argmax are exact integer work either way — so
both references are plain numpy and any dataset whose descriptor declares a reproducible
`test_split` can be dumped locally. MNIST's is `tail:10000`, the canonical split, since `mnist_784`
ships in train-then-test order. JSC's split was made in a notebook with a seed, so the script
**refuses** it rather than inventing a different split and calling it the test set.

⚠️ **It validates before it writes.** A test set with the wrong split, scaling or row order
produces a Gate 1b run that looks completely normal and means nothing. So the script regenerates
the rows that already exist in the committed `_testvectors.npz` and requires an exact match on
both features and predictions before saving anything. It reproduced all 1,000, and the float32
accuracy came out at 96.1400% against the checkpoint's recorded `final_acc` of 0.9614 — an
independent confirmation, since that number came from a Kaggle GPU run months of plumbing ago.

New dependencies: `scikit-learn` (the OpenML fetch) and `pandas` (which `fetch_openml`'s default
parser requires for dense data). Only this script imports them; a missing scikit-learn degrades
test-set dumping and nothing else.

#### ⚠️ The accuracy to quote here is 96.14%, not 96.77%

Both numbers are real and they measure different checkpoints. **96.1400%** is
`mnist_n6_z3_distributive_w300`, which is what is in the bitstream, on the board, and verified to
the sample. **96.77%** is `..._tau1p678`, the retrained model after the `tau` correction, whose
checkpoint is **not in `training/artifacts/` on this machine** and has therefore never been
exported, synthesized or run. Quote 96.14% for anything describing the hardware; quote 96.77% only
as the corrected training result, and re-run this whole chain before the two are merged into one
claim.

### 2026-08-12 — the dataset descriptor became load-bearing, and it was carrying nothing

`datasets/` was written in M1a as the single place dataset facts live. **Nothing imported it.** It
held the right numbers while every consumer kept a private copy of JSC's, which is why the same
defect kept surfacing one crash at a time — seven sites now, all the same shape: *a dataset
constant sitting where a derived value belongs*.

| # | site | wrong for MNIST because |
|---|---|---|
| 1 | `emit_core.py` `16 * thermometer_bits` | 784 features, not 16 |
| 2 | `record_bytes()` `word_bits // 8` | 9 bits is 2 bytes, floor gives 1 |
| 3 | `uart_loader.v` `reg [5:0]` | caps at 63; the record is 1,568 bytes |
| 4 | testbenches `[2:0]` class index | 10 classes need 4 bits |
| 5 | `dwn_basys3_top.v` `correct_count[7:0]` | part-select past the end at ADDR_W=4 |
| 6 | `extract.py` `FRAC_BITS/WORD_BITS` | Q3.12 imported as a default by six modules |
| 7 | `host.py` `WORD_BITS // 8`, `'33 bytes'` | the same two defects again, in the host |

**The fix that makes it stop: `datasets.identify(ck)`**, which matches a checkpoint to its
descriptor on `(features, classes)`. Deliberately not on the filename — a slug is a naming
convention, and resolving behaviour through one means a renamed checkpoint silently changes its
quantisation. An unrecognised shape raises with instructions instead of falling back to JSC.

**`exporter/extract.py` has no module constants at all now.** `quantize`, `quantize_thresholds`,
`saturation_is_lossless` and `fits_in_word` take the widths as **required** arguments. That is the
part that makes this durable rather than tidy: a missing argument is a `TypeError` at the call
site, whereas a default is a plausible wrong number that reaches the FPGA. `--word-bits` and
`--frac-bits` survive as explicit overrides, because sweeping width is a real experiment; what is
gone is *inheriting* a width without saying so.

`experiments/` was deliberately left JSC-bound, but now says so: `FRAC_BITS = datasets.JSC.frac_bits`.
Those are JSC analyses outside the dataset-agnostic contract, and one of them hardcodes
`LUT_PER_BIT = 1519 / 202` outright. Stating the binding is honest; pretending it is universal was
the original error.

#### Verification — the contract is "identical, not close", and it held

| check | result |
|---|---|
| JSC single-layer, `verify_phase1.py` | **12/12**, areas 110 / 1,519 / 1,621 identical |
| JSC two-layer `300-100`, `run_gate1.py` | **PASS** both levels |
| JSC on silicon, `--with-board` | **22/22**, Gate 1b 166,000/166,000 |
| MNIST, `run_gate1.py`, **no precision flags** | **PASS** both levels |

That last row is the evidence the refactor did its job: MNIST previously required
`--word-bits 9 --frac-bits 8` and now requires nothing. The only argument left that the checkpoint
genuinely cannot supply is `--depth`, which is a property of the bitstream rather than the model.

**The §1.5 contract is now testable rather than aspirational:** a third dataset means adding a
`Dataset` and a `docs/<name>/` directory. `test_split` was added as a descriptor field in this
pass for exactly that reason — the dump script needed a dataset fact, and the fact went into the
descriptor rather than into the script.

### 2026-08-11 — the harness cost was one line of Verilog, and MNIST fits without streaming

**MNIST now builds to a bitstream at 4,586 LUTs (22.05%) and meets 100 MHz with +0.292 ns.** It
was 10,460 LUTs (50.29%) and had not been through implementation. Nothing about the model
changed; `dwn_top` is 1,543 LUTs in both.

The cause was `uart_loader.v`:

```verilog
wr_data[byte_idx*8 +: 8] <= rx_data;      // was
wr_data <= {rx_data, wr_data[DATA_W-1:8]}; // now
```

A variable part-select **write** synthesises to a `VEC_BYTES`-way address decoder driving a write
enable on every byte lane. At JSC's 32 lanes that is 439 LUTs and nobody notices. At MNIST's 1,568
it was **6,343 LUTs and 5,228 FF — four times the classifier it exists to feed.** Bytes arrive in
order and are never revisited, so the decoder buys nothing; inserting at the top and shifting down
leaves byte 0 at `[7:0]` after `VEC_BYTES` bytes, which is the same little-endian layout
`tb/gen_vectors.py` and `scripts/host.py` already pack.

| design | before | after |
|---|---|---|
| MNIST `dwn_basys3_top` | 10,460 LUTs (50.29%), post-synth, never routed | **4,586 (22.05%), 10,746 FF, WNS +0.292 ns** |
| MNIST `u_loader` | 6,343 LUTs, 5,228 FF (post-synth) | **463 LUTs, 6,404 FF, 274 SRL** |
| JSC `dwn_basys3_top` | 2,060 LUTs, 865 FF, WNS +1.753 ns | **1,893 LUTs, 864 FF, WNS +2.014 ns** |
| JSC `u_loader` | 439 LUTs | **77 LUTs** |

⚠️ **Post-route unless marked**, from `utilization_routed.rpt`. The MNIST "before" exists only
post-synth because that build was interrupted during `opt_design`, so the 10,460 → 4,586 span
mixes two report stages and slightly overstates the win; the like-for-like post-synth pair is
10,460 → 4,585. Every JSC row is post-route on both sides.

#### ⚠️ A prediction that was wrong, and the mechanism it missed

The change was proposed as *"this moves cost from LUTs to flip-flops"* — reasoning that a
12,544-bit shift register still needs 12,544 flops, so the win would be modest and would show up
as an FF increase. **LUTs fell 13.5× and flops rose only 1.2×.** The missing mechanism is that a
shift register can be mapped into **SRL16/SRL32 primitives** — a LUT holding 16 or 32 bits of
shift depth instead of one bit of logic — and an indexed write forbids that mapping, because any
element may be written at any time. MNIST's build shows 278 LUTs used as shift register absorbing
what would otherwise be thousands of flops. The lesson is narrower than "shift registers are
good": *the access pattern determines which primitives are reachable*, and a decoder-shaped write
locks the design out of the cheapest one.

#### This retires the argument for streaming, at least for MNIST

Streaming was proposed to eliminate `u_store`'s 2,416 LUTs of distributed RAM — real, since a
12,544-bit-wide store cannot map to block RAM (a BRAM36 is at most 72 bits wide, so one cycle of
that width would need ~175 of the 50 on the device; the build reports **0 BRAM** for MNIST against
8 for JSC). But **fit is no longer the binding problem** — 22% with timing met — so streaming is
now a throughput and convenience change, not an enabling one. `DEPTH=16` at the default
`--bram-budget` means 625 load/run batches for the 10,000-sample test set.

**What streaming would still buy, and what it would cost:** it removes the store entirely
(≈2,400 LUTs, taking the design to roughly 2,200) and makes a full test pass one command instead
of 625. What it gives up is the `cycle_count` measurement — the batch path preloads and issues one
vector per clock, which is what makes that number a real II=1 throughput figure comparable to the
paper (brief §9). Streaming is UART-bound at ~314,000 cycles per record, so it can measure
**accuracy only**. That is why both loaders should coexist rather than one replacing the other,
and it is the concrete reason the harness is organised by *mechanism* rather than by dataset.

#### Scope note

`dwn_core` and `dwn_top` are untouched — `uart_loader` is harness, outside `dwn_top` — so **no
Phase 2 frontier point moves.** The only recorded number affected is `verify_phase1.py`'s
`board_luts`, updated 2060 → 1893 with `board_ff` 865 → 864.

#### ✅ Verified on silicon — and the area check caught a reporting error first

`verify_phase1.py --with-board`, JSC, after the loader change:

| | result |
|---|---|
| **Gate 1b** | **166,000 / 166,000** |
| core cycles (II=1) | 166,815 — exact |
| accuracy float32 / Q3.12 | 73.8361 / 73.8349 — both exact |
| board LUTs / FF | 1,893 / 864, meets 100 MHz |

The shift-register loader is correct on hardware, not just in simulation.

⚠️ **The run first came back 20/22**, and the cause was this ledger, not the design. `EXPECTED`
had been filled in from `utilization.rpt` (post-synth, 1896/861) while `build_bitstream.py` parses
`utilization_routed.rpt` (post-route, 1893/864) — the source every historical figure here,
including 2058 and 2060, came from. Two builds of the same design were then confirmed byte-
identical, so nothing was stochastic; one report stage had simply been read for another.

**Worth keeping because the failure mode is general:** the wrong number was within 0.2% of the
right one. A tolerance check would have passed it and the two stages would now be mixed across the
document. `verify_phase1.py` demands exact equality precisely so a 3-LUT discrepancy is loud, and
that is the second time on this branch the strictness has paid for itself.

#### Still not on silicon: MNIST

The MNIST bitstream is built and meets timing but has not been programmed. Its loader runs 1,568
shift iterations against JSC's 32, so the large-`VEC_BYTES` path remains simulation-only.

### 2026-08-11 — ⚠️ the testbench was checking three of MNIST's four class-index bits

Found by sweeping Gate 1 across class counts before trusting the argmax change — not by suspecting
anything. K=2 and K=3 failed, and they failed at the `jsc-complete` argmax too, so it was never
about argmax.

```verilog
tb/dwn_core_tb.v:39   wire [2:0] class_idx;          // JSC has five classes
tb/dwn_top_tb.v:32    wire [2:0] class_idx;
                      if (class_idx !== expected[j][2:0])
```

| classes | `idx_w` | what the testbench did |
|---|---|---|
| 2, 3 | 1, 2 | DUT drives fewer bits than the wire; the rest float. `rtl=Z`, always fails |
| 5–8 | 3 | correct — the only range ever exercised |
| **10, 16** | **4** | **truncates. Only three of four bits compared** |

**So the MNIST Gate 1 pass reported earlier today was checking three of the four index bits.** A
design that predicted class 9 where the golden model said class 1 — differing only in bit 3 —
would have passed. Re-run with the fix, MNIST passes on all four bits, so the result was correct;
but it was correct by luck rather than by verification, and it was reported with more confidence
than it had earned.

**This is the fourth instance of one pattern**, after `emit_core.py`'s `16 * thermometer_bits`,
`Dataset.record_bytes()`'s `word_bits // 8`, and `uart_loader.v`'s `reg [5:0] byte_idx`. Every
time: a fixed-width thing sitting beside a derived one, failing silently or for the wrong reason.

**This one was in the testbench** — the component whose entire purpose is catching this class of
error. Worth stating plainly: *the verification apparatus is not exempt from verification.* Gate 1
proved the RTL matched the golden model on the bits it compared, and said nothing about the bit it
did not.

`tb/gen_vectors.py` now emits `` `IDX_W `` and both testbenches derive from it.

#### Verified after the fix

| | |
|---|---|
| Gate 1 at K = 2, 3, 5, 7, 10, 16 | all PASS |
| JSC `1x50`, JSC `300-100`, MNIST `1x300` | all PASS |
| `verify_phase1.py` | 12/12 at the re-measured 110 / 1,621 |
| harness testbenches | uart, benchmark, loader, top — all pass |
| MNIST timing | 108.0 MHz, meets the 100 MHz board clock |

### 2026-08-11 — timing: the argmax was a linear chain, and fixing it hit the published-numbers wall

MNIST missed the board clock at **87.5 MHz**. It now closes at **108.0 MHz** and is slightly
smaller, 1,557 -> 1,548 LUTs. JSC is untouched: **12/12, areas 108 / 1,519 / 1,619.**

#### It was not a pipelining problem

The obvious move was a pipeline sweep, and there was nothing to sweep: `PIPE_LUT`, `PIPE_POP`,
`PIPE_OUT` and `PIPE_ENC` were all already 1. Those knobs are binary, so JSC's Group B could only
ever *remove* stages to trade Fmax for latency. Nothing was left to switch on.

The timing report named the path instead of leaving it to guesswork:

```
Source:      u_core/u_pipe_pop/g_reg.r_reg[0]/C
Destination: u_core/u_pipe_out/g_reg.r_reg[1]/D
Data Path Delay: 11.373ns   Logic Levels: 17
```

Register-after-popcount to register-after-argmax — so the **argmax**, not the popcount.

#### Why one loop became a chain and the other did not

Both primitives are written as `for` loops in `always @*`. Only one of them synthesized badly:

| | code | what synthesis does |
|---|---|---|
| `popcount.v` | `count = count + bits[i]` | addition is **associative**, so the tool rebalances it into an adder tree by itself |
| `argmax.v` | `if (x > best) best = x` | a **data-dependent select chain**; each step needs the previous `best`, and the tool leaves it linear |

So the argmax was K-1 dependent compare-selects. At JSC's K=5 that is 4 deep and never mattered.
At MNIST's K=10 it is 9 deep, 17 logic levels, and it set the clock. **Writing a reduction as a
loop is fine when the operator is associative and a latent depth bug when it is not.**

#### The fix, and the wall it hit

A balanced tree makes the depth `ceil(log2(K))`: 4 instead of 9. It closed timing immediately.

**It also cost JSC +2 LUTs** — `dwn_core` 108 -> 110, `dwn_top` 1,619 -> 1,621 — and
`verify_phase1.py` failed on exactly that, which is what it is for.

Two LUTs sounds ignorable. It is not, and the reason is worth recording:

- **108 and 1,619 are published**, in `README.md`, `docs/jsc/report.md` and three phase reports.
- `verify_phase1.py`'s own message says re-measured areas must not share a table with old ones.
- **All 54 JSC configs have K=5**, so all of them move together — but *not by a constant*. Argmax
  cost depends on K **and** W, the score width, which is `ceil(log2(group+1))` and varies with
  layer width. There is no offset to subtract; it needs re-measuring.
- So adopting the tree everywhere means **re-running the whole 54-config sweep** to keep the
  Phase 2 frontier self-consistent. Tens of hours of Vivado, to buy nothing at K=5, which already
  closes 147 MHz.

First attempt at avoiding the cost was to drop the power-of-two padding, on the theory that dummy
leaves were paying for themselves. They were not: with padding removed JSC still measured 110. The
tree muxes indices up its levels where the chain assigns a constant per stage, and that is
inherent, not incidental.

**First resolution, since withdrawn: a `K <= 5 ? chain : tree` switch**, to hold the published
number still.

**⚠️ That was the wrong call, and the argument against it is worth keeping.** A branch is
legitimate when it encodes a discontinuity in the *target*: `MAX_N = 6` is real, because at n=7 a
node stops being one LUT6. `CHAIN_MAX = 5` encoded a fact about **this project's git history** —
nothing about the FPGA changes at five classes, and the chain is not better there, merely what was
measured first. Branches like that do not compose: the next dataset arrives with some other K and
there is no principled place to put it, only a growing table of historical accidents, each needing
its own verification.

The mechanism for holding a published result still is a **tag**, not frozen RTL. `jsc-complete`
already exists; papers cite a commit for exactly this reason. Freezing code to protect a printed
number inverts the relationship and taxes every future improvement.

**Final: the tree is unconditional.** `EXPECTED` in `verify_phase1.py` moves to 110 / 1,621, with
the pre-change values reproducible at `jsc-complete`, and `docs/jsc/report.md` and `README.md` now say the
JSC figures are measured there. The shift is **0.12% at `1x50` and 0.02% at the headline config** —
no frontier point, knee or conclusion moves. `docs/jsc/results/sweep-results.json` still holds
chain-era areas, so the two must not share a table without saying so.

#### For the tool: tree unconditionally

`docs/reference/tool-roadmap.md` should carry this. The constraint above is specific to this repository —
the tool has no frozen baseline to protect, and a user may arrive with 100 classes, where a
depth-99 chain is pathological. Two LUTs at K=5 costs nothing when nothing downstream is pinned to
it.

The general lesson for the generator is larger than argmax: **any reduction it emits should be
explicitly balanced rather than left to synthesis**, because whether the tool rescues a loop
depends on whether the operator is associative — and that is not a property the emitter should be
relying on silently.

### 2026-08-11 — M1d + M1e: MNIST runs, 96.14% in 1,557 LUTs, and it misses the clock

The first real MNIST model through the whole flow. `1x300`, z=3, n=6, Q0.8 nine-bit words.

#### Gate 1 PASSES on a trained model

```
golden model vs PyTorch on the real vectors: 1000/1000
Q0.8 vs float32 on those same vectors: 0 encoder bit differences, 0 class changes
dwn_core : 1,504 vectors, 0 mismatches, PASS
dwn_top  : 1,865 vectors, 0 mismatches, PASS
```

**The quantisation is lossless**, which is the prediction the descriptor was built on and the
first time it has been confirmed. JSC's Q3.12 produced 10 encoder bit differences against float32;
MNIST at nine bits produces **zero**, because min-max scaled 8-bit pixels take only 256 distinct
values and Q0.8 represents every one of them exactly. Narrowing cost JSC accuracy because it
truncated *continuous* features; there is nothing to truncate here.

#### Area, post-place-and-route, `xc7a35tcpg236-1` at 10 ns

| module | LUTs | % device | FF | BRAM | DSP | Fmax |
|---|---|---|---|---|---|---|
| `dwn_core` | 640 | 3.08% | 354 | 0 | 0 | 92.2 MHz |
| `thermometer_encoder` | 918 | 4.41% | 0 | 0 | 0 | 289.4 MHz |
| **`dwn_top`** | **1,557** | **7.49%** | 906 | **0** | **0** | **87.5 MHz** |

**Encoder/core is 1.43x** — against 14.1x for JSC's smallest model. `z=3` is why: 2,352
thermometer bits against JSC's 3,200 for a *tenth* as many features. The encoder stops dominating
when the thresholds per feature are few, whatever the feature count.

#### Against the published MNIST numbers

| | accuracy | LUTs | part |
|---|---|---|---|
| PolyLUT (brief §8) | 96% | 70,673 | `xcvu9p` |
| NeuraLUT (brief §8) | 96% | 54,798 | `xcvu9p` |
| **this work** | **96.14%** | **1,557** | `xc7a35t-1` |

**Same accuracy, 35–45x fewer lookup tables.** That is a far stronger position than JSC, where we
were not competitive on area at all.

⚠️ **The accuracy row is superseded: `1x300` retrains to 96.77% at the corrected `tau`.** The
1,557 LUTs was measured on the 96.14% checkpoint, and `tau` cannot change the topology, so the
area is expected to be identical — but **expected is not measured**, and this project does not
quote unverified pairs. Re-export the corrected checkpoint, re-run Gate 1, re-synthesize, and only
then update the row as a matched pair.

⚠️ **Before anyone quotes it**, four things have to be checked, and none is done:
- **The published rows come from brief §8, which was stale for JSC** and needed a full refresh.
  These MNIST numbers have had no such audit.
- **The encoder convention** was the trap on JSC. It must be established per row for MNIST too.
- **MNIST may not have JSC's two-dataset problem**, but that must be verified rather than assumed.
- **Our design does not meet the board clock** (below), so it is not yet a deployable result.

#### ⚠️ It misses 100 MHz

**87.5 MHz, failing by 1.425 ns.** The core alone is 92.2 MHz; the encoder is fine at 289. So the
critical path is the popcount and argmax over 300 nodes in 10 groups, exactly as it was for JSC —
**timing, not area, is the binding constraint here too.**

Pipelining is the lever and it needs no retraining: JSC's Group B moved 84.2 to 161.0 MHz on
flip-flops alone, with the LUT count unchanged. **M1g cannot proceed until this closes.**

#### The area model is fine — the synthetic run was the outlier

| | projected | measured | error |
|---|---|---|---|
| comparators | 785 | 720 | +9.0% |
| encoder | 832 | 918 | −9.4% |
| core | 684 | 640 | +6.9% |
| **design** | **1,516** | **1,557** | **−2.6%** |

**This retracts the alarm in the synthetic entry above.** That run showed the projection 26% low
overall and 82% low on the encoder, and I attributed it to the 49x feature-count extrapolation. On
a *real* checkpoint the same model is within 2.6%. The error was the synthetic data: uniformly
random pixels produce threshold spreads nothing like real MNIST, where most pixels are zero and
quantile thresholds cluster hard.

**The lesson is about synthetic checkpoints, not about the model.** They are excellent for testing
the *emitter* — that is what they were built for, and Gate 1 at 784 features passed on one before
any training existed. They are worthless for predicting *area*, because area depends on the data
distribution the thresholds were fitted to.

### 2026-08-11 — M1f: the harness derives its dimensions, and a third silent-cap bug

**JSC unchanged: 12/12, areas 108 / 1,519 / 1,619**, and all four harness testbenches pass —
`uart`, `benchmark`, `loader`, `top` — including the end-to-end board-integration simulation.

#### ⚠️ `uart_loader.v` looked parameterised and was not

`VEC_BYTES = DATA_W / 8` is derived, not hardcoded, so the module reads as general. Two lines
below it:

```verilog
reg [5:0] byte_idx;                       // caps at 63
if (byte_idx < VEC_BYTES[5:0]) begin      // truncates
```

A fixed-width counter silently overriding the parameters around it. For MNIST, `VEC_BYTES` is
1,568 and `[5:0]` truncates it to **32** — the loader would have accepted JSC-sized records
forever and written garbage into the vector store, with nothing anywhere reporting an error.

`IDX_W` is now `$clog2(REC_BYTES + 1)` and every literal `6'd0` follows it.

**This is the third instance of one pattern**, and it is worth naming: `emit_core.py`'s
`16 * thermometer_bits`, `Dataset.record_bytes()`'s `word_bits // 8`, and now this. In each case a
*parameter existed*, and something narrower downstream quietly capped it. None of the three would
have raised an error. The common tell is a **fixed-width thing sitting next to a derived one** —
worth grepping for deliberately rather than waiting to trip over the next one.

#### `scripts/host.py` had the byte-alignment version of the same bug

`pack_record` used `word_bits // 8`, giving **one byte for a 9-bit word** and truncating every
feature. Both packers now use ceiling division, and `pack_batch` derives its numpy dtype rather
than hardcoding `'<i2'` — which happened to be right for 16-bit and 9-bit alike, and would have
been wrong the moment anything else was tried.

#### Dimensions now come from the model

`scripts/build_bitstream.py` reads the checkpoint and passes `DATA_W / LABEL_W / DEPTH / ADDR_W`
as Vivado generics. The generics path already existed end to end and was only being used for
`BAUD`.

| | features | record | DATA_W | LABEL_W | DEPTH | BRAM |
|---|---|---|---|---|---|---|
| **JSC** | 16 | 33 B | **256** | **3** | **1024** | 14% |
| MNIST (9-bit) | 784 | 1,569 B | 12,544 | 4 | 16 | 11% |

**JSC's row is the validation**: those are exactly the values that were hand-written into
`dwn_basys3_top.v`, now derived rather than typed. If the derivation were wrong, that row would
have moved.

**MNIST gets `DEPTH=16` at the default 15% block-RAM budget** — a vector is 48x wider, so far
fewer fit. A 10,000-vector test set then needs ~625 load-and-run batches. `--bram-budget 0.5`
raises it to 64 and ~157 batches. That is throughput, not correctness, and it is the cost that was
accepted when MNIST went on the board.

#### ⚠️ What is NOT verified

**None of this has run on hardware.** `verify_phase1.py` at 12/12 covers simulation and
synthesis; the board half needs `--with-board` and a Basys 3, and it has not been run since the
loader changed. The four testbenches exercise the same RTL a bitstream would, so the risk is low —
but "passes in simulation" is not the standard this project uses for the board, and Gate 1b exists
precisely because simulation missed things before.

**Run `scripts/verify_phase1.py --with-board` on the machine with the board before trusting any of
this.** Expected: 22/22, and JSC's 166,000/166,000 unchanged.

### 2026-08-11 — the generator works at MNIST's shape, measured, before any training

`experiments/make_test_checkpoint.py --dataset mnist` (added by the other machine in `42d9b0b`,
on top of the `datasets/` descriptors from M1a — the two tracks met without coordination). It
fabricates a checkpoint at any dataset shape, so **Gate 1 can run at 784 features and 10 classes
with nothing trained.**

That is legitimate because Gate 1 verifies the *emitter*, not the model: both sides are derived
from the same checkpoint, so random tables exercise the machinery as well as learned ones, and
better in one respect — they reach address patterns a trained model may never produce. It is the
argument `make_test_checkpoint.py` was written for, and it is what caught the `np.packbits` shift
at n<3.

#### Gate 1 PASSES at MNIST's shape

`1x300`, z=25, n=6, 784 features, 10 classes, Q0.8 nine-bit words:

```
1,734 distinct bits selected of 19,600
dwn_core : 1,504 vectors, 0 mismatches, PASS
dwn_top  : 2,199 vectors, 0 mismatches, PASS
```

**The mechanical half of M1d is answered.** Port widths, wiring indices, address ordering and the
4-bit class index are all correct at a shape nothing has been trained at.

#### And it synthesizes — with two findings

Place-and-routed, `xc7a35tcpg236-1`, 10 ns:

| | projected | **measured** |
|---|---|---|
| comparators | 1,353 | **1,734** |
| encoder | 1,434 | **2,607** |
| core | 684 | **641** |
| top | 2,557 | **3,233 (15.5%)** |
| timing | — | ❌ **FAILS — 91.5 MHz** |

**⚠️ The area projection was 26% low, and the encoder specifically was 82% low.** Two errors
compounded: 28% more comparators than the occupancy model predicted, and **1.50 LUTs per
comparator against the 1.06 measured on JSC at nine bits.** The 49x extrapolation on feature count
does not hold as well as the 2026-08-11 threshold analysis implied. Treat every number in that
entry as indicative, not predictive.

**⚠️ It misses the board clock at 300 nodes.** 91.5 MHz against the required 100, with the core
itself at 94.2. JSC's `1x50` closed 147 MHz. Ten classes make the popcount groups wider relative
to layer width, and MNIST's ladder goes to 2,000 nodes — so **timing, not area, is likely to be
MNIST's binding constraint too**, exactly as it was for JSC. Pipeline depth is a synthesis-side
sweep needing no retraining, and the harness already parameterises it.

#### ⚠️ RETRACTED 2026-08-11 — the amortisation explanation below does not survive a third point

Written from two measurements. The real MNIST model is the third, and it breaks the trend:

| design | word | comparators | features | per feature | LUTs each |
|---|---|---|---|---|---|
| JSC `1x2400 z=50` | 9 | 746 | 16 | 46.62 | 1.06 |
| MNIST **synthetic** z=25 | 9 | 1,734 | 784 | 2.21 | 1.50 |
| MNIST **real** z=3 | 9 | 720 | 784 | **0.92** | **1.27** |

"Fewer comparators per feature means less sharing, so each costs more" predicts the real model
should be the dearest. It has the fewest per feature of the three and is **cheaper** than the
synthetic one. The claim is withdrawn.

**A better candidate, and it is a hypothesis rather than a finding:** what matters is the
threshold *values*, not how many share a feature. Real MNIST pixels are mostly zero, so quantile
thresholds cluster near zero, and a comparison against a near-zero constant collapses to a test
on a couple of bits. The synthetic run's uniform random pixels spread thresholds across the whole
range, where every comparison is a full-width compare against an arbitrary constant.

**Testable**, and cheaply: emit the same model at several `z` and compare LUTs per comparator
against the threshold distribution. Not done. **Nothing downstream should rest on either
explanation until it is.**

The original text is kept below, struck through, because the reasoning error is the useful part:
a mechanism inferred from two points, stated with more confidence than two points support.

#### ~~The cost-per-comparator gap has a cause, and it is a finding in its own right~~

The 1.06 -> 1.50 LUTs-per-comparator miss is not noise and not a missing optimisation. Learnable
Reduction and encoder narrowing are in neither the prediction nor the measurement, and configurable
precision *was* used — this ran at nine bits. It is amortisation:

| design | word | comparators | features | **per feature** | LUTs each |
|---|---|---|---|---|---|
| JSC `1x2400 z=50` | 16 | 746 | 16 | 46.6 | 7.71 |
| JSC `1x2400 z=50` | 9 | 746 | 16 | 46.6 | **1.06** |
| MNIST synthetic `1x300 z=25` | 9 | 1,734 | 784 | **2.2** | **1.50** |

Same word width, 42% dearer per comparator, and twenty times less sharing per feature. Every
comparator on one feature reads the same input word, so synthesis amortises the common decode
across them; JSC spreads it over ~47 comparators, MNIST over 2.2.

**So a wide, shallow input costs more per comparator than a narrow, deep one** — an architectural
property of thermometer encoding on this fabric, and one the JSC study could not have found because
it never varied the feature count. It also means the encoder cost model needs a
comparators-per-feature term, not just a width term (roadmap R1).

⚠️ **Provisional: the MNIST half is synthetic.** Real pixels are mostly zero, so quantile
thresholds will collapse onto duplicates and the real comparators-per-feature ratio will differ —
probably lower still, which would make the effect stronger. Re-measure at M1e on a trained model
before this goes in any report.

#### What this does NOT establish

Real MNIST pixels are **mostly zero**, so quantile-placed thresholds will collapse onto duplicates
in a way uniform synthetic data never does. Duplicate thresholds cost nothing in hardware, so the
real design is likely **cheaper** than the numbers above. Nothing here says anything about
accuracy, about whether upstream's checkpoints have the structure we expect, or about Gate 1b.
The trained models are still required for every result.

### 2026-08-11 — T3: what upstream actually does for MNIST, and it is not what we assumed

Read from `third_party/DWN/examples/mnist.py` and `src/torch_dwn/`, at the pinned commit. Three
risks retired, one assumption overturned.

#### ✅ The checkpoint format holds

Upstream binarises MNIST with the **same `DistributiveThermometer`** class as JSC, and
`feature_wise=True` is the default, so thresholds are per-feature quantiles exactly as
`docs/reference/checkpoint-format.md` describes. No new format work.

#### ✅ Both wiring representations are already exercised

Upstream's MNIST stacks `LUTLayer(..., mapping='learnable')` then `LUTLayer(...)` — and
`LUTLayer`'s default is **`mapping='random'`**, a fixed mapping. So layer 2 uses the `§3b` fixed
path, not the learnable one.

That could have been a nasty surprise. It is not: our `300-100` JSC checkpoint is **learnable then
fixed**, so both paths are already Gate 1 verified. Recorded so nobody re-audits it.

#### ✅ No StandardScaler, and nothing needs one

Upstream feeds `transforms.ToTensor()`, which puts pixels in **[0, 1]** — no scaler at all, unlike
our JSC path. Checked whether that breaks us: `exporter/`, `rtlgen/` and `tb/` never read
`ck['scaler']`; only a comment in `emit_encoder.py` mentions it. So an MNIST checkpoint without a
scaler flows through unchanged. The descriptor's `scaling='minmax'` is right.

#### ⚠️ Upstream uses `DistributiveThermometer(3)` — z=3, not the 25 we planned

This is the overturned assumption. **Three thresholds per pixel**, giving 784 x 3 = 2,352
thermometer bits, against the 19,600 our z=25 recommendation implied.

It is consistent with the 2026-08-11 threshold finding rather than contradicting it: MNIST is
slot-limited, so `z` buys little area either way. But it means the accuracy knob probably sits far
lower than JSC's 200, and upstream — who trained these models — chose 3.

Projected at Q0.8, nine bits:

| config | z=3 | z=8 | z=25 |
|---|---|---|---|
| `1x300` | **9.4%** | 10.6% | 12.3% |
| `1x1000` | 21.6% | 26.3% | 31.1% |
| `2000, 1000` (upstream's own) | **32.9%** | 41.7% | 52.1% |

**Upstream's full MNIST model projects to roughly a third of the device.** That is a far better
starting position than the paper's `1000, 500` at 16 bits, which was over the device entirely.

**Revised bring-up recommendation: `1x300`, z=3, n=6, min-max to [0,1].** Matching upstream's `z`
removes a variable — if accuracy disappoints, that is a training question, not a suspicion about
our binarisation. Sweep `z` afterwards, when it is an accuracy knob rather than a guess.

#### Also worth noting

Upstream's example is `2000, 1000`, not the paper's `1000, 500`, and uses `tau = 1/0.3`. Neither
blocks anything, but the two sources disagree about what "the MNIST model" is, and the paper's
Table 14 is the one `docs/reference/paper-configs.md` records.

### 2026-08-11 — M1b: precision is a parameter, and the golden model moves with it

The fixed-point format was a constant in `exporter/extract.py` (`FRAC_BITS = 12`,
`WORD_BITS = 16`) that everything downstream read. Building the same checkpoint at another width
meant editing source. **At 16 bits nothing MNIST-shaped fits this device** — the paper's
configuration is 102.5% at its cheapest and 160% at z=50 — so this was a blocker, not a tidy-up.

**JSC is unchanged:** 12/12 with areas 108 / 1,519 / 1,619, the emitted RTL byte-identical to
`rtl/example-model-1x50/`, and the two-layer `300-100` checkpoint still bit-exact.

| file | change |
|---|---|
| `exporter/extract.py` | `required_int_bits()` — derives the exact integer-bit floor from the thresholds |
| `rtlgen/emit_encoder.py` | `--word-bits` / `--frac-bits`; refuses a word too narrow for the thresholds |
| `tb/gen_vectors.py` | the same flags, so the golden model quantises identically |
| `scripts/run_gate1.py` | takes both and passes **one shared list** to the encoder and the vector generator |
| `rtlgen/config.py` | comment only |

#### The one detail that matters

`run_gate1` builds the precision flags **once** and hands the same list to both the encoder emitter
and the golden-model generator. Give those two different widths and Gate 1 compares two *different
designs* and still reports PASS — a green light on a comparison that means nothing. Constructing
the list in one place makes that unrepresentable rather than merely unlikely.

#### What is derivable, and what is not

Following the V4 argument in `docs/reference/tool-roadmap.md` §4, which is the right one:

**Integer bits are derivable exactly.** `required_int_bits()` returns the floor below which a
threshold cannot be represented at all, and the emitter refuses to build there:

```
ABORT: Q0.7 cannot represent this model. Its thresholds span +/-4.545 and need 3
integer bits; a 8-bit word with 7 fractional bits has 0.
```

**Fractional bits are not.** Whether quantisation changes predictions depends on the data, not the
checkpoint. `required_int_bits()`'s docstring says so and cites the scar: the encoder-narrowing
result in `docs/jsc/report.md` §5.6 was fitted and validated on the same 1,000 samples, and 8 of 15 features
came out too narrow. **The code reports a floor as a floor and never calls a width safe.**

#### Verification

| test | result |
|---|---|
| default vs the committed `1x50` reference | byte-identical, all files |
| **11-bit (Q3.7), Gate 1** | **PASS — bit-exact on 1,518 vectors** |
| two-layer `300-100`, Gate 1 | PASS |
| word too narrow for the thresholds | refused, with the numbers |
| `verify_phase1.py` | 12/12, areas identical |

**The 11-bit pass is the substantive one.** Everything else confirms nothing regressed; that one
shows the golden model and the RTL agree at a width neither was written for, which is the property
MNIST depends on.

#### A correction to `docs/reference/tool-roadmap.md`

F1 read `rtlgen/config.py:186-187` as asserting that the config equals the module constants, and
therefore as an obstacle. It checks `HardwareConfig()` — the **default** instance — so it means
"the default agrees with the module that owns it", which is a drift guard worth keeping. Nothing
needed relaxing. A comment now says so, in case a later reader takes it for the blocker.

#### Not done here, deliberately

`scripts/host.py` still reads the module constants. It is the board path, which is decision-pending
under M1f, and threading it halfway would leave the host and the Verilog loader disagreeing about a
wire format. It moves as one piece or not at all.

### 2026-08-11 — M1a: the feature count is derived, and `datasets/` exists

Two generalisation changes, both gated. **JSC is unchanged: 12/12 with areas 108 / 1,519 / 1,619,
and the two-layer `300-100` checkpoint still passes Gate 1 bit-exact on 1,519 vectors.**

#### The defect

`rtlgen/emit_core.py` computed the core's input port width as `16 * cfg['thermometer_bits']` —
JSC's feature count written into the emitter. Now derived from the thresholds themselves
(`thresholds.size`, which is features × z), matching what `rtlgen/emit_encoder.py` already did.

**This was wrong on `main` today**, not merely wrong for MNIST. It is the dangerous kind: a wrong
port width elaborates and synthesizes, then disagrees with the encoder feeding it. Nothing errors.

`scripts/host.py`'s self-test had the same constant twice — `rec[:WORD_BITS * 16 // 8]` and a
literal `!= 33`. Both now derive from the record. `pack_record` itself was already general.

**A fast check worth reusing:** `rtl/example-model-1x50/` is the committed emitted RTL for the
Phase 1 config. Regenerating it and diffing gives a byte-exact answer in seconds, covering table
contents, wiring indices and port widths, long before Vivado has an opinion. All five files came
back identical.

#### `datasets/` — the contract, and it caught a bug immediately

One frozen `Dataset` descriptor per dataset: dimensions, scaling, fixed-point format, record
layout, sweep axes. `check_checkpoint()` raises if a descriptor disagrees with a trained model,
because a silently wrong descriptor produces an export that elaborates and is wrong.

| | features | classes | format | record |
|---|---|---|---|---|
| `jsc` | 16 | 5 | Q3.12 | **33 B** |
| `mnist` | 784 | 10 | Q0.8 | 1,569 B |

JSC's 33 bytes is **derived and matches the constant the UART loader was written around**, which
is the check that the derivation is correct rather than merely plausible.

⚠️ **The contract found a real bug within the hour.** `record_bytes()` first used
`word_bits // 8`, which returns **one byte for an 11-bit word** and silently truncates every
feature. Fixed with ceiling division. **`scripts/host.py`'s `pack_record` still makes the same
assumption** — deliberately left, because it shares a wire format with `harness/uart_loader.v` and
the two must change together, which is M1f.

#### That bug forced a better decision on MNIST precision

The descriptor initially carried 11 bits, taken from the JSC measurement. Wrong reasoning: MNIST
pixels are 8-bit integers and min-max scaled, so **only 256 distinct input values exist** and
**Q0.8 — nine bits, one sign and eight fractional — represents them exactly.** JSC's 0.4 pp loss at
nine bits came from truncating *continuous* features; there is nothing to truncate in data that
arrives already quantised. Nine bits also sits on the cheap side of the measured area cliff.

Still provisional. On JSC the accuracy-safe width moved between two configurations of the *same*
dataset, so it cannot be assumed to transfer to a different one.

#### Not done here, deliberately

`dse/area_model.py` still has `JSC_FEATURES = 16`. It is outside the directories §1.3 covers, and
it belongs to the R1 recalibration, but it should read from the descriptor when that happens.

### 2026-08-11 — threshold analysis: `z` is not the constraint for MNIST, word width is

`experiments/mnist_threshold_analysis.py`. This reverses the intuition carried over from JSC and
retracts a number written into this ledger yesterday.

**Method.** Comparator counts come from `dse/area_model.predict_comparators`, an occupancy model
with a fitted correction. Validated first against **37 JSC checkpoints spanning z=8-800 and widths
65-3000: 3.9% mean error, 10.9% worst.** LUTs-per-comparator are *measured*, not modelled, from
`experiment_encoder_area.py` — the area model scales cost linearly with word width and that is
wrong, because of the cliff between 12 and 11 bits.

#### ⚠️ RETRACTION: the "~67,000 LUTs of encoder" estimate was wrong

This ledger's own scale table said the paper's MNIST configuration extrapolates to roughly 67,000
LUTs of encoder. That assumed every one of the first layer's `6 x 1000 = 6,000` input slots reads a
**distinct** thermometer bit. It does not. The learned mapping reuses bits heavily and saturates:
the model puts it at **2,425 distinct comparators at z=8, rising only to 5,638 at z=200**.

Corrected, for `1000, 500`:

| word | encoder | core | total | device |
|---|---|---|---|---|
| 16-bit, z=8 | 18,697 | 2,178 | 21,314 | **102.5% — over** |
| 16-bit, z=50 | 30,678 | 2,178 | 33,295 | 160.1% — over |
| **11-bit, z=50** | **5,292** | 2,178 | **7,909** | **38.0%** |
| 8-bit, z=50 | 3,502 | 2,178 | 6,118 | 29.4% |

#### The finding, and it inverts the JSC conclusion

**Comparators grow with `z` far more slowly than they did on JSC.** From z=8 to z=200 — a 25x
increase — the count rises only 2.3x, and total device use goes 28% to 49%.

The reason is which side of the ceiling each dataset sits on. On JSC, `16 x z` gave 3,200 bits
against a few hundred slots, so the *pool* was the binding limit and `z` set it directly — which is
why cutting z from 200 to 50 there saved 40% of the silicon. On MNIST, `784 x z` is 6,272 bits at
z=8 alone, against 6,000 slots, so the encoder is **slot-limited, not pool-limited.** Adding
thresholds mostly adds bits nobody reads.

**So the JSC lesson "z is the expensive axis" does not transfer.** For MNIST:

- **At 16-bit the paper's configuration does not fit at any z**, z=8 included, at 102.5%.
- **At 11-bit every configuration tested fits**, from 28% to 49% of the device.

**Configurable precision (M1b) is therefore a blocker, not an optimisation.** It is what decides
whether MNIST runs on this board at all. That is a change in its priority, and the plan's ordering
already puts it second, which now looks right for a reason we had not established.

#### Bring-up candidates, single layer, 11-bit

| config | z | comparators | encoder | core | total | device |
|---|---|---|---|---|---|---|
| `1x200` | 25 | 999 | 1,329 | 448 | 2,216 | 10.7% |
| **`1x300`** | **25** | **1,353** | **1,799** | **684** | **2,923** | **14.1%** |
| `1x500` | 25 | 1,990 | 2,647 | 1,178 | 4,264 | 20.5% |
| `1x1000` | 50 | 3,979 | 5,292 | 2,463 | 8,194 | 39.4% |

**Recommended for M1c: `1x300`, z=25, n=6.** Small enough that a failure means one thing, large
enough to exercise 784 features and 10 classes, and the width divides by 10 so the reduction is
even. `1x200` also works; `256` does not, because the final layer must divide by the class count.

#### What could make all of this wrong

- **A 49x extrapolation on the one axis never swept.** All 37 calibration configs have 16 input
  features. The occupancy mathematics is dimension-agnostic but the fitted correction is not.
- **MNIST pixel statistics are nothing like JSC's.** Most pixels are zero most of the time, so
  quantile-placed thresholds will collapse onto identical values in a way JSC's continuous physics
  features never did. Duplicate thresholds cost nothing, so the real comparator count is probably
  **lower** than modelled — this is likely pessimistic, but it is untested either way.
- **The 11-bit cliff was measured on JSC's threshold distribution.** Whether it sits at the same
  width for MNIST is unknown, and the JSC evidence is that the safe width *moved* between two
  configs of the same dataset.
- **8-bit is natural for MNIST** — pixels are natively 8-bit integers — but JSC lost 1.09 pp at 8
  bits, so it needs its own accuracy measurement, not an assumption.

**None of this replaces synthesizing one real MNIST configuration, which is M1e.**

---

## To record once the board work lands

Placeholders, so the questions are asked rather than reconstructed afterwards. Every one needs
hardware and cannot be filled in from here.

| | What to capture | Why it matters |
|---|---|---|
| ~~**JSC regression on silicon**~~ | ✅ **22/22, 166,000/166,000** on 2026-08-12, after both the loader change and the descriptor refactor | The loader changed. Simulation says it is fine; silicon has disagreed with simulation before |
| ~~**MNIST `DEPTH` actually used**~~ | ✅ **16 at the default `--bram-budget 0.15`, and 0 BRAM** — a 12,544-bit-wide store cannot map to block RAM at all, so it fell to 2,416 LUTs of distributed RAM. JSC uses 8 BRAM at DATA_W=256 | Answered by synthesis, not hardware — the store's width is what decides this, and width is known without a board |
| ~~**Batches for a full pass**~~ | ✅ **625 batches at `DEPTH=16`, 31.9 s** for 10,000 vectors — 313 samples/s over the link | Measured, not projected. The earlier ~23 min projection assumed 115,200 baud; 5 Mbaud is 43× faster |
| ~~**Baud actually achieved**~~ | ✅ **5 Mbaud, and the sweep is deliberately skipped.** Not a measured ceiling — a working rate | **Decided 2026-08-12:** the I/O wall is 243,271×, so the link is already the entire cost and a faster link changes no reported number. JSC swept baud because 480 s → 11.2 s made the test set practical to run at all; MNIST's full pass is 31.9 s at 5 Mbaud, which is not a constraint on anything. Revisit only if a Phase 2 config makes a full pass painful |
| ~~**Bitstream area at MNIST dimensions**~~ | ✅ **4,586 LUTs (22.05%), 10,750 FF, 0 BRAM, WNS +0.292 ns.** Harness share 3,043 LUTs — `u_loader` 468, `u_store` 2,416 | ⚠️ **The premise was wrong: the harness DOES scale with the model.** It was assumed fixed at ~439 LUTs from JSC. `u_store` scales with record width by construction, and `u_loader` did too until the shift-register fix. Both were found by measuring at a second dataset |
| ~~**Gate 1b result**~~ | ✅ **0 mismatches out of 10,000.** Q0.8 also differs from float32 on 0/10,000 — lossless on the full set, with 56,835 values saturating harmlessly | The actual deliverable of M1g |
| ~~**Timing with the harness attached**~~ | ✅ **100 MHz closes, WNS +0.292 ns post-route.** Margin is thin — 2.9% — so a wider config or a slower corner could lose it | The synthetic core missed at 91.5 MHz *without* the harness; the real model plus harness makes it, which is the argmax tree rather than anything the harness does |

⚠️ **The synthetic run already suggests timing will be the problem, not area.** If the real model
misses 100 MHz, pipeline depth is the lever and it needs no retraining — but it changes the
latency figure that goes in the report, so measure before quoting.

## Open questions

| Question | Status |
|---|---|
| ~~How many thermometer thresholds per pixel is right?~~ | ✅ **Settled 2026-08-11.** `z` is cheap here — MNIST is slot-limited, so z=8→200 costs only 2.3× in comparators. **Upstream uses z=3** (T3), so start there rather than the 25 first guessed, and treat `z` as an accuracy knob afterwards. |
| ~~Are MNIST pixels standard-scaled or min-max normalised?~~ | ✅ **Closed 2026-08-11: min-max, [0,1]**, via `transforms.ToTensor()`. No scaler in the pipeline, and nothing in our flow requires one |
| ~~Does the upstream MNIST recipe binarise differently from JSC?~~ | ✅ **Closed 2026-08-11: no.** Same `DistributiveThermometer`, `feature_wise=True`. Both wiring paths (learnable, fixed) already Gate 1 verified by our `300-100` checkpoint |
| How many MNIST vectors fit in the vector store? | ⬜ Open. Sets whether Gate 1b is one pass or many |
| Does the paper's `1000, 500` fit at any precision? | ⬜ Open. A negative answer is a result, not a failure |
| ~~Does the **tool** ship a harness?~~ | ✅ **Closed 2026-08-11: no, generator-only.** Users bring their own, as hls4ml does. The encoder still ships — intrinsic to a DWN and most of the area, so omitting it would repeat the reporting failure `docs/jsc/report.md` §5.2 criticises |
| ~~Does MNIST run on our board in this repo?~~ | ✅ **Closed 2026-08-11: yes.** M1f and M1g are in scope. Separate from the tool question — the tool still ships generator-only; the board demo is this project's own deliverable, and a second dataset on real silicon is a far stronger result than a second dataset in simulation |
| How many MNIST vectors fit in the vector store? | ⬜ Open, and only matters if the board answer is yes. ~48× wider per vector than JSC, so `DEPTH` falls to order 100 |
| ~~Is `1x300`'s 96.14% understated by `tau`?~~ | ✅ **Closed 2026-08-11: yes, by +0.63 pp — the bring-up model is 96.77%, not 96.14%.** `GroupSum` divides by `tau`, and `tau=3.3333` at group 30 gives a logit range of 9 against the anchor's 30, so this rung trained ~2× hot. Retrained at `tau=1.678`: **96.77%** (best 96.88%), checkpoint `mnist_n6_z3_distributive_w300_tau1p678`. **Gate 1 and every area and timing number are unaffected** — `tau` is a training-time constant that never reaches hardware — but the accuracy quoted for this design should be the corrected one. Full analysis, including why the narrow rungs moved 5× as much: `docs/mnist/reduction-ledger.md` |
