Kanishk234/dwn-fpga-study/releases/phase1/MANIFEST.md

# Phase 1 release — the design that passed Gate 1b

A frozen copy of the bitstream that passed Gate 1b on hardware, plus everything needed to say
exactly what produced it. Phase 2 will churn the emitters, the RTL and the sweep scripts; this
directory does not change.

**This bitstream is not a fallback for a broken future build — it is the reference.** If a
Phase 2 change makes the board misbehave, reflashing this tells you within a minute whether the
board and the toolchain are fine and the change is at fault.

---

## What passed

```
GATE 1b -- 2026-08-04, Digilent Basys 3 (XC7A35T-1CPG236C)

samples              : 166000        (the entire JSC test set)
hardware == software : 166000/166000
core cycles          : 166815        = 166000 + 162 x (LATENCY+1), so II=1 held on silicon
wall clock           : 11.2 s        at 5 Mbaud
accuracy, float32 model      : 73.8361%
accuracy, Q3.12 (on hardware): 73.8349%
```

Reference for the comparison is the **Q3.12 golden model** — the spec the hardware implements —
not the float32 model. The two differ on 30 of 166,000 samples (0.018%), worth −0.0012 pp; that
is reported as characterization, not folded into the pass/fail.

## Provenance

| | |
|---|---|
| commit | `034ed160cbb50e67722c981d4fe99b191e62a5aa` |
| date | 2026-08-04 |
| bitstream | `dwn_basys3_top.bit`, sha256 `0753c65075731081…`, 2.19 MB |
| checkpoint | `dwn_jsc_t200_distributive_50_l_b100_checkpoint.pt`, sha256 `cdd51914260c919d…` |
| test vectors | `dwn_jsc_t200_distributive_50_l_b100_testvectors.npz`, sha256 `5a5e73df3106d162…` |
| Vivado | 2025.2 |
| Python | 3.12.10, `requirements.txt` as committed |
| upstream `torch_dwn` | pinned at `9f887a0` |

Both artifact files are committed under `training/artifacts/`. The **full 166k test set is
not** — it is ~9.4 MB and gitignored, regenerated by `training/dump_testset_kaggle.ipynb`.
Keep a copy somewhere; regenerating it needs a Kaggle GPU session.

## The model

The paper's JSC **`sm`** configuration (arXiv:2410.11112, Table 14), reproduced:

| | |
|---|---|
| architecture | single LUT layer, 50 nodes, n=6, learnable mapping |
| encoder | distributive thermometer, z=200 → 3200 bits, of which **202** are wired |
| input format | Q3.12 signed, 16-bit, saturating |
| reduction | 5 × popcount(10) → argmax, lowest index wins ties |
| pipeline | 4 stages, II=1 |
| software accuracy | 73.84% (paper's `sm`: 74.0%) |

## Resource use

| Scope | LUTs | FF | BRAM | DSP | Fmax |
|---|---|---|---|---|---|
| `dwn_core` (out-of-context) | 108 | 73 | 0 | 0 | 158.9 MHz |
| `thermometer_encoder` (OOC) | 1519 | 0 | 0 | 0 | 342.9 MHz |
| `dwn_top` (OOC) | 1619 | 269 | 0 | 0 | 147.1 MHz |
| **whole board design** | **2058 (9.89%)** | **865** | **8** | **0** | +1.753 ns @ 100 MHz |

Out-of-context numbers are the ones comparable to the paper (its Table 2 is out-of-context too);
the board row is what is actually on silicon. **Report both, never one as the other.**

The core reproduces the paper almost exactly — **108 LUTs against their reported 110**.

## Reproducing this

```
.venv\Scripts\python.exe scripts\run_gate1.py          # regenerate RTL + prove it in sim
.venv\Scripts\python.exe scripts\build_bitstream.py    # build (no flags: 5 Mbaud default)
.venv\Scripts\python.exe scripts\program.py            # flash over JTAG
.venv\Scripts\python.exe scripts\host.py --gate1b      # 166000/166000, ~11 s
```

Bit-for-bit identical output is not expected — Vivado placement varies run to run — but area,
timing and the Gate 1b result should reproduce.

## Reflashing this exact bitstream

```
.venv\Scripts\python.exe scripts\program.py --bit releases\phase1\dwn_basys3_top.bit
```

Programming is volatile: it is lost on power cycle or on pressing PROG. Nothing is written to
flash.

## Using the board

`sw[1:0]` selects the seven-segment display: `00` last class, `01` cycle count, `10` correct
count, `11` cycle count high word. Classes are alphabetical — `0=g, 1=q, 2=t, 3=w, 4=z` — not
the physics ordering.

`led[0]` busy, `led[1]` a run finished, **`led[2]` UART framing error (sticky)**, `led[3:4]`
echo the switches, `led[15:8]` low byte of the correct count.

On a machine that has never run this: set the **FTDI latency timer to 1 ms** or the run is ~21%
slower with no other symptom. `scripts/host.py` detects and warns; `--set-latency 1` fixes it
from an Administrator shell.
