Kanishk234/dwn-fpga-study/docs/phase3-ledger.md

# Phase 3 ledger — the Controlled Comparison (Study 2)

Running log for Phase 3. Plan: `docs/phase3-plan.md`. Handoff: `docs/phase3-handoff.md`.

**Split:** the *hands-on half* (conifer, hls4ml — plan §2) runs on the machine with the Phase 1/2
toolchain; the *literature half* (plan §3–§4) needs no board, no Vivado and no synthesis and runs
on the other. **Both halves are now logged here** — see the note under the status table for which
machine produced which rows. Where an entry corrects an earlier one written from the other side,
it says so rather than editing it away.

---

## Status

| Step | What | Status |
|---|---|---|
| 3L-a | Refresh the literature list — brief §8 is stale (plan §3 ⚠️) | ✅ done 2026-08-10 |
| 3L-b | Settle the encoder-convention trap (plan §4.1) | ✅ done 2026-08-10 |
| 3L-c | Pull per-paper JSC numbers into a machine-readable table | ✅ done 2026-08-10 — `cc/literature/` |
| 3L-d | Combined comparison table + Pareto plot with our 15 frontier points | ✅ done 2026-08-11 — `cc/literature/plot.py`, figures in `docs/results-cc/` |
| 3X-a | Encoder input-word width: accuracy floor + area curve | ✅ done 2026-08-10 — **5.9x smaller encoder** |
| 3X-b | Re-run 3X-a at `1x2400 z=50` before quoting anything | ✅ done 2026-08-10 — **the width limit moved; the saving held** |
| 3L-e | Phase 3 report | ✅ done 2026-08-11 — `docs/phase3-report.md`, covers both halves |
| 3M-a | conifer (GBDT) — *hands-on machine* | ✅ done 2026-08-10 — **14 configs, `docs/results-cc/`** |
| 3M-b | hls4ml (quantized MLP) — *hands-on machine* | ✅ done 2026-08-10 — **6 configs, it fits at 16/8/8** |

**Both halves now have entries in this ledger.** The literature half (3L-\*) runs on the machine
that wrote this file; the hands-on half (3M-\*) runs on the machine that holds the Phase 1/2
toolchain — Vivado/Vitis 2025.2, and the venv `scripts/verify_phase1.py` validates. Every
hands-on row below was produced there, through `scripts/build.tcl` at `xc7a35tcpg236-1` / 10 ns,
so it is directly comparable to the 54 DWN results.

---

## Log

### 2026-08-10 — ✅ 3M-b RUN AFTER ALL: hls4ml fits an XC7A35T at 16/8/8, and the DSP claim is now measured

*(hands-on machine)* `cc/hls4ml/run_hls4ml.py`. Supersedes the "scoped out" entry below, which
stays visible because its *reasoning* about cost was right — it was the toolchain assessment that
was wrong.

**None of the predicted blockers were real.** hls4ml 1.3.0 needs **no WSL, no second Vivado
install, no `vitis_hls` shim and no TensorFlow**: its Vitis backend already issues
`vitis-run --tcl build_prj.tcl --mode hls`, guards its POSIX tool-detection with
`if 'linux' in sys.platform`, passes build options through a *file* rather than trailing
arguments, and `convert_from_pytorch_model` uses the torch already pinned. Install cost was five
small packages; numpy 2.3.4 and torch 2.13.0 were untouched.

#### The shrink sequence — the result plan §2.2 was actually after

Published architecture is **16→64→32→32→5** (Duarte/Fahim). Trained in PyTorch on the same split,
same seed, same scaler as everything else. All rows post-route on `xc7a35tcpg236-1` at 10 ns.

| config | reuse | precision | acc (float) | LUTs needed | vs 20,800 | DSPs |
|---|---|---|---|---|---|---|
| `64/32/32` | 1 | `<16,6>` | 76.69% | **259,492** | 12.5× over | 3,214 |
| `64/32/32` | 4 | `<16,6>` | 76.69% | 189,608 | 9.1× over | 1,064 |
| `32/16/16` | 4 | `<16,6>` | 76.33% | 52,927 | 2.5× over | 340 |
| `64/32/32` | 16 | `<16,6>` | 76.69% | 45,844 | 2.2× over | 266 |
| `32/16/16` | 4 | `<12,6>` | 76.33% | 26,883 | 1.3× over | 340 |
| **`16/8/8`** | 4 | `<12,6>` | **75.67%** | **8,749** | ✅ **42.1% — FITS** | **53** |

**It takes quarter-width layers plus 12-bit precision plus 4× time-multiplexing to fit.** The
published architecture does not fit at *any* reuse tested — still 2.2× over at reuse=16, at full
accuracy.

**Reuse is sub-linear, and it beats width.** 1→4 bought only 1.4×; 4→16 bought 4.1×. And
`64/32/32` at reuse 16 (45,844) is *smaller* than `32/16/16` at reuse 4 (52,927) while scoring
0.36 pp better — so time-multiplexing dominates narrowing as an area lever, and it costs latency
rather than accuracy.

#### Against DWN at matched area — DWN wins every column

| | LUTs | DSP | BRAM | latency | accuracy |
|---|---|---|---|---|---|
| hls4ml `16/8/8` | 8,749 | **53** | 2 | **34 cyc, II=4** | 75.67% *(float upper bound)* |
| **DWN `1x1200 z=50`** | **8,444** | **0** | **0** | **4 cyc, II=1** | **76.05%** |

Smaller, more accurate, no DSPs, no BRAM, **8.5× lower latency and 4× the throughput**. And DWN's
headline `1x2400 z=50` reaches 76.18% at 12,751 LUTs — an accuracy hls4ml never reaches at any
size that fits here.

**The DSP argument is no longer unexercised.** 53 DSPs is **59% of this part's 90**, against 0 for
all 52 DWN and all 14 conifer configs.
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
