Kanishk234/dwn-fpga-study/docs/jsc/results/sweep-results.csv

name | label | status | nodes | n | z | encoding | layers | pipe | clock_ns | accuracy_pct | dwn_core_luts | thermometer_encoder_luts | dwn_top_luts | dwn_top_ff | dwn_top_bram | dwn_top_dsp | device_pct | dwn_top_fmax_mhz | latency | predicted_board_luts | predicted_extrapolated | impl | seconds
n2_z200_distributive_w200_q16.12_p1111_c10 | 1x200 n=2 | ok | 200 | 2 | 200 | distributive | [200] | 1111 | 10.0 | 74.0639 | 450 | 1910 | 2319 | 476 | 0 | 0 | 11.15 | 124.5 | 4 | 2926 | True | True | 201.7
n2_z200_distributive_w360_q16.12_p1111_c10 | 1x360 n=2 | ok | 360 | 2 | 200 | distributive | [360] | 1111 | 10.0 | 74.6349 | 852 | 2839 | 3635 | 758 | 0 | 0 | 17.48 | 117.7 | 4 | 4953 | True | True | 239.9
n4_z200_distributive_w200_q16.12_p1111_c10 | 1x200 n=4 | ok | 200 | 4 | 200 | distributive | [200] | 1111 | 10.0 | 75.0271 | 466 | 3352 | 3795 | 668 | 0 | 0 | 18.25 | 126.8 | 4 | 4956 | True | True | 218.8
n4_z200_distributive_w360_q16.12_p1111_c10 | 1x360 n=4 | ok | 360 | 4 | 200 | distributive | [360] | 1111 | 10.0 | 75.4711 | 867 | 5294 | 6129 | 1085 | 0 | 0 | 29.47 | 115.2 | 4 | 8600 | True | True | 284.2
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
