Kanishk234/dwn-fpga-study/docs/mnist/results/sweep-results.csv

name | label | status | nodes | n | z | encoding | layers | pipe | clock_ns | accuracy_pct | dwn_core_luts | thermometer_encoder_luts | dwn_top_luts | dwn_top_ff | dwn_top_bram | dwn_top_dsp | device_pct | dwn_top_fmax_mhz | latency | predicted_board_luts | predicted_extrapolated | impl | seconds
n2_z3_distributive_w1000_q9.8_p1111_c10 | 1x1000 n=2 | ok | 1000 | 2 | 3 | distributive | [1000] | 1111 | 10.0 | 96.3 | 2257 | 996 | 3240 | 1673 | 0 | 0 | 15.58 | 95.3 | 4 | 3105 | True | True | 310.8
n4_z3_distributive_w1000_q9.8_p1111_c10 | 1x1000 n=4 | ok | 1000 | 4 | 3 | distributive | [1000] | 1111 | 10.0 | 97.57 | 2272 | 1147 | 3414 | 1784 | 0 | 0 | 16.41 | 92.5 | 4 | 3105 | True | True | 366.1
n6_z1_distributive_w1000_q9.8_p1111_c10 | 1x1000 z=1 | ok | 1000 | 6 | 1 | distributive | [1000] | 1111 | 10.0 | 97.91 | 2272 | 846 | 3118 | 1505 | 0 | 0 | 14.99 | 95.4 | 4 | 2970 | True | True | 370.5
n6_z25_distributive_w1000_q10.8_p1111_c10 | 1x1000 z=25 | ok | 1000 | 6 | 25 | distributive | [1000] | 1111 | 10.0 | 98.23 | 2272 | 2935 | 5195 | 2818 | 0 | 0 | 24.98 | 92.8 | 4 | 4773 | True | True | 984.0
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
