Kanishk234/dwn-fpga-study/(commit log)

2026-08-02 add lut6 mapping probe
2026-08-02 record probe results and retire risk 1
2026-08-02 pin project to python 3.12 and record why
2026-08-03 measure fixed-point precision needed for thermometer encoder
2026-08-03 add thermometer encoder and top-level rtl
2026-08-03 extend gate 1 to the full encoder-plus-core datapath
2026-08-03 add running phase 1 ledger
2026-08-03 add out-of-context synthesis flow and record area results
2026-08-03 add parameterized pipeline stages
2026-08-03 make gate 1 clocked and constrain synthesis at the board clock
2026-08-03 add uart rx and tx with loopback test
2026-08-03 record uart harness progress
2026-08-03 add uart loader and host protocol
2026-08-03 record uart loader and host protocol
2026-08-03 add board top level and seven segment driver
2026-08-03 add board integration test with real golden vectors
2026-08-03 add place and route stage to the build flow
2026-08-04 add host driver with encoding self-test
2026-08-04 record host driver and full test set
2026-08-04 measure encoder area breakdown and narrowing experiment
2026-08-04 record encoder scaling projection
2026-08-04 auto-detect the board serial port
2026-08-04 fix gate 1b reference model and saturate quantized features
    [host.py]
2026-08-04 raise baud to 1M and add correct count to the display
    [dwn_basys3_top.v, host.py]
2026-08-04 detect and fix the ftdi latency timer from the host
    [host.py]
2026-08-04 link the phase 1 report from the ledger
2026-08-04 add phase 2 ledger
2026-08-04 correct board lut count and slack in phase 1 ledger
2026-08-04 add encoder sharing analysis
2026-08-04 record encoder sharing dead end and 22/22 acceptance pass
2026-08-07 regenerate core params with pipeline stage defines
2026-08-07 add area model calibrated on phase 1 measurements
2026-08-07 widen the z sweep to span both encoder regimes
2026-08-07 record measured sweep results
    [sweep-results.csv]
2026-08-07 implement the area filter with a probe band
2026-08-07 log 2d and refresh the results snapshot
    [sweep-results.csv]
2026-08-07 verify multi-layer and correct stale ledger claims
2026-08-07 add z and encoding filters for splitting across machines
2026-08-08 record accuracy for filtered configs
2026-08-08 log the filtered accuracy change
2026-08-08 add measure-filtered to synthesize too-big configs
2026-08-08 correct the encoder narrowing result, it was fitted and tested on the same data
2026-08-08 add exact-slug filter for picking up stragglers
2026-08-08 record measured sweep results for 37 configs
    [sweep-results.csv]
2026-08-09 backfill bram and dsp into the published results
    [sweep-results.csv]
2026-08-09 record final sweep results for 39 configs
    [sweep-results.csv]
2026-08-09 refresh results after normalizing the 1x50 row
    [sweep-results.csv]
2026-08-09 raise vivado thread count to 8, verified identical results
2026-08-09 log group b extension, thread verification, and the queued corners
2026-08-09 refresh results and figures for 48 configs
    [sweep-results.csv]
2026-08-09 explain the datapath stage by stage
2026-08-09 record final results for 54 configs
    [sweep-results.csv]
2026-08-10 add phase 3 ledger, refresh the literature list
2026-08-10 add encoder input width experiment
2026-08-10 add encoder width area sweep
2026-08-10 log the encoder width result and its phase 2 impact
2026-08-10 add the conifer gbdt comparison flow
2026-08-10 log the conifer flow and correct the toolchain entry
2026-08-10 close 3X-b, merge conifer ledger entries, correct the toolchain notes
2026-08-10 commit the conifer comparison measurements
    [conifer-results.csv]
2026-08-10 add the hls4ml comparison flow
2026-08-10 commit the hls4ml comparison measurements
    [hls4ml-results.csv]
2026-08-11 plot the measured hls4ml result and close two stale ledger rows
2026-08-11 add the mnist plan, ground rules, and phase 1 ledger
2026-08-11 derive the encoder width from the checkpoint instead of assuming 16 features
2026-08-11 separate the tool scope from whether mnist runs on our board
2026-08-11 make the input fixed-point format a parameter instead of a constant
    [gen_vectors.py, run_gate1.py]
2026-08-11 put mnist on the board and split the work between machines
2026-08-11 derive the board record format and vector store from the model
2026-08-11 log m1f and list what the board work still has to record
2026-08-11 apply the slug filter before the grid is grouped
2026-08-11 log the first mnist model through the flow
2026-08-11 pin the published jsc figures to the jsc-complete tag
2026-08-12 record the post-tree jsc board lut count
2026-08-12 unpack byte-padded record lanes in the board harness
2026-08-12 log the loader shift register and the mnist board build
2026-08-12 correct the board area to post-route and record jsc gate 1b
    [verify_phase1.py]
2026-08-12 resolve fixed-point format from the dataset descriptor
    [build_bitstream.py, gen_vectors.py, host.py]
2026-08-12 record board area and gate 1b in the mnist snapshot
2026-08-12 open the mnist phase 2 ledger with the handoff
2026-08-12 add a noise floor grid, four configs at four seeds
    [mk_noise_floor_nb.py]
2026-08-12 point the ledgers at the noise floor run
2026-08-12 point the reduction ledger at the noise floor notebook
2026-08-12 audit the tool roadmap against phase 1 and add the encoder cost model gap
2026-08-12 derive the encoder word width per config
2026-08-13 print the dataset's own snapshot path
2026-08-13 snapshot the mnist sweep results
    [sweep-results.csv]
2026-08-13 close the mnist phase 2 ledger and record the device_pct denominator error
2026-08-13 retract the denominator claim and record the outstanding board run
2026-08-13 open the mnist phase 3 ledger
2026-08-13 reorganise docs into jsc, mnist and reference
    [conifer-results.csv, hls4ml-results.csv, sweep-results.csv]
