Kanishk234/dwn-fpga-study/(notices)

Notices in the files:
docs/phase3-ledger.md:
**WARP Logic Neural Networks** (Gerlach et al., arXiv:2602.03527, Feb 2026) | Walsh-relaxation training for logic nets | **absent**; no JSC hardware numbers — training paper, cite as related work only
